olxssa/perfusion_automation/FreeCAD_Files/syringe_pumps/688085-open-source-syringe-pumps-e49d6351-b8a2-4a63-a908-39e2536a6fdb.pdf

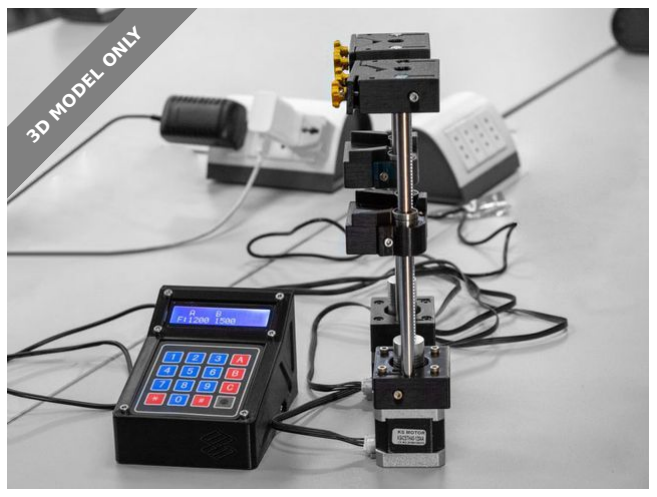
[picture p13: figure]
3D MODEL ONLY

## Summary

3D printable syringe pumps for laboratory or hobby use, including microfluidics, mass-spectrometry, and microscopy.

Learning (https://printables.com/model?categoryId=90) > Chemistry & Biology (https://printables.com/model?categoryId=92)

Tags: | motor | stepper | electronics | pump | microfluidics
opensource | syringe | m3 | openhardware | droplet
heatinsert | librehub

The open-source syringe pump is a standard research instrument for use in microfluidics and several other laboratory workflows. There are numerous designs available in the realm of open-source syringe pumps. We have combined some the best features available based on a preexisting versatile design.

To build these pumps you can check our free documentation. (https://librehub.github.io/syringe-pumps-and-controller/testpage1.html) To make modifications see our online CAD model. (https://cad.onshape.com/documents/20c077b452e92115525d4fed/w/71118f46b0924c1bb22b1150/e/4bcaa57486327617beecf77e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)

Our strobe-enhanced microscopy stage (https://www.printables.com/model/647564-strobe-enhanced-microscopy-stage) works great with these syringe pumps, to complete an open-source workstation for imaging fast processes, particularly developed for microfluidic droplet generation.

LIBRE hub (https://printables.com/@WenzelLab)

## Open-Source Syringe Pumps

VIEW IN BROWSER (https://printables.com/model/688085-open-source-syringe-pumps)

updated 9. 5. 2024 | published 9. 5. 2024

Open-Source
Syringe
Pump

## Model files

This is a re-design and modification of the "Open-Source Syringe
Pump" (https://link.springer.com/article/10.1134/S1061934820030156) (documentation) (https://www.mass-spec.ru/projects/diy/syringe_pump/eng/) developed by Andrey Samokhin, made by Matías Hurtado Labarca (https://librehub.github.io/people/matias_hurtado/index.html) and Tobias Wenzel (https://twitter.com/MakerTobey) as part of the LIBRE hub (https://librehub.github.io/) project.

## This remix is based on

Open-Source Syringe Pump (https://www.mass-spec.ru/projects/diy/syringe_pump/eng/)

- Simulation
- Optional Holding System for retraction assembled-syringe-pump.stl

small-syringe-holder.stl

add-on-end-stop-limit.stl

add-on-thread-holder.stl

large-syringe-holder.stl

add-ons-to-operate-pumps-in-retraction-mode.stl

## License

This work is licensed under a
Creative Commons (4.0 International License)

Attribution (http://creativecommons.org/licenses/by/4.0/)

✖ | Sharing without ATTRIBUTION
✔ | Remix Culture allowed
✔ | Commercial Use
✔ | Free Cultural Works
✔ | Meets Open Definition

base-syringe-holder.stl

knob.stl

base-carriage.stl

base-stepper-motor-plate.stl
