olxssa/perfusion_automation/FPC/from_memetis/image 2.png

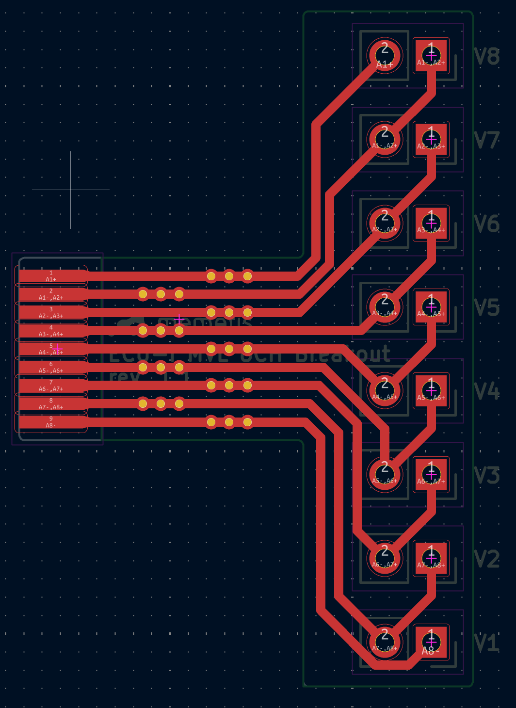
FPC/from_memetis/image 2.png
