olxssa/perfusion_automation/FPC/from_memetis/image.png

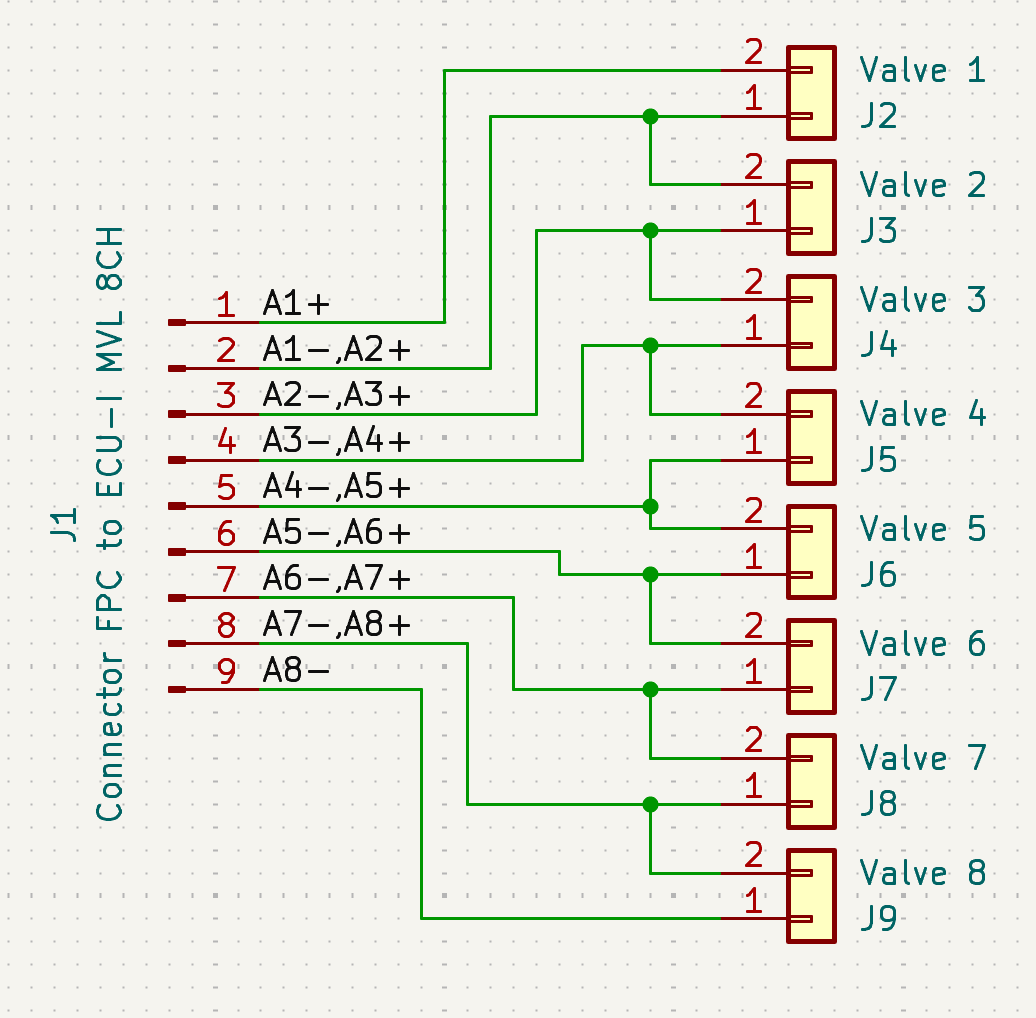
FPC/from_memetis/image.png
