olxssa/perfusion_automation/images/electrical_circuit.jpg

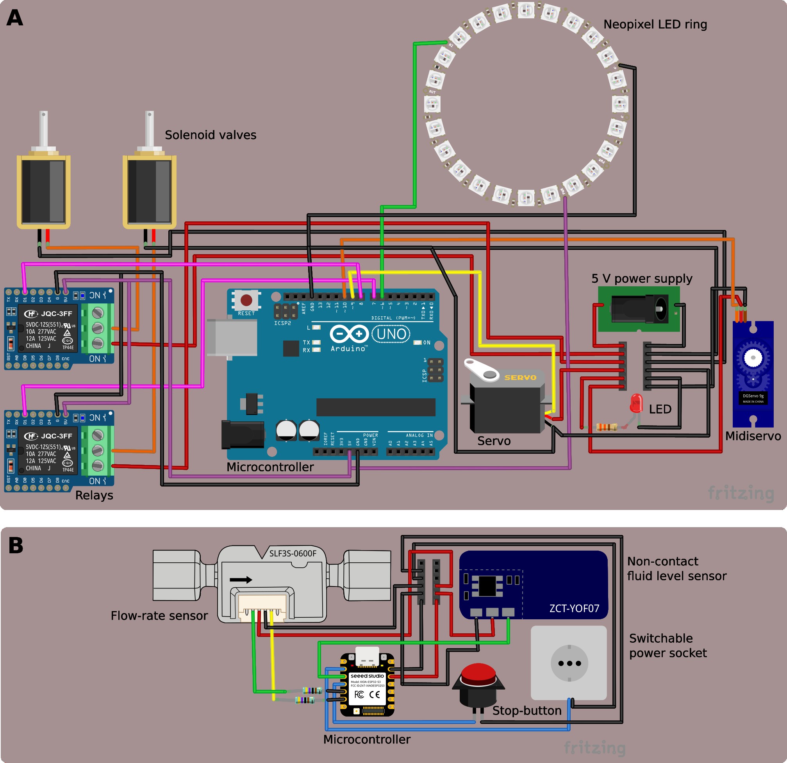
images/electrical_circuit.jpg
