olxssa/perfusion_automation/images/electrical_circuit.png

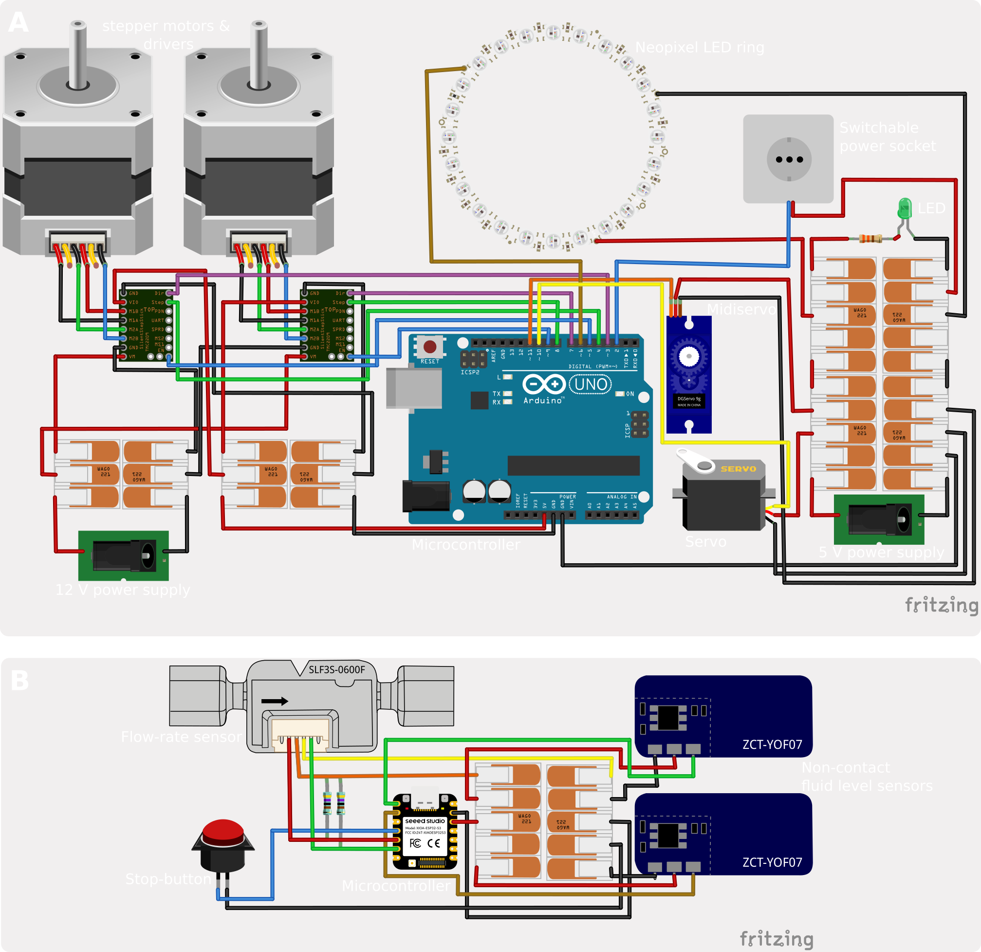
images/electrical_circuit.png
