olxssa/perfusion_automation/images/fluidic_circuit.jpg

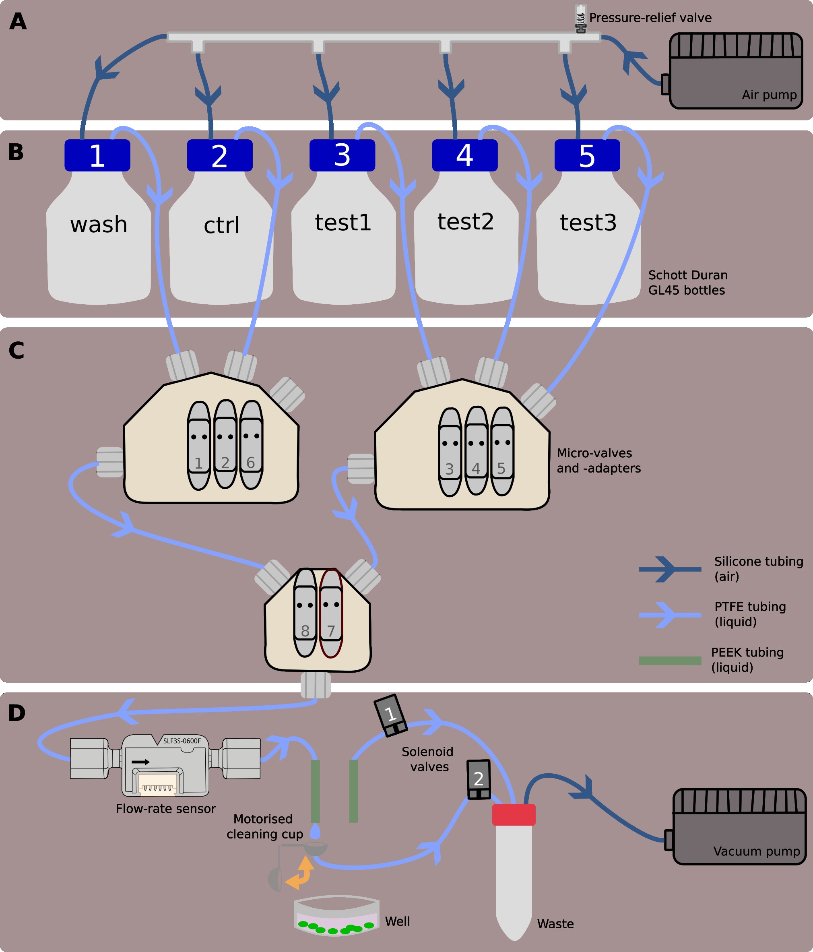
images/fluidic_circuit.jpg
