olxssa/perfusion_automation/images/fluidic_circuit.png

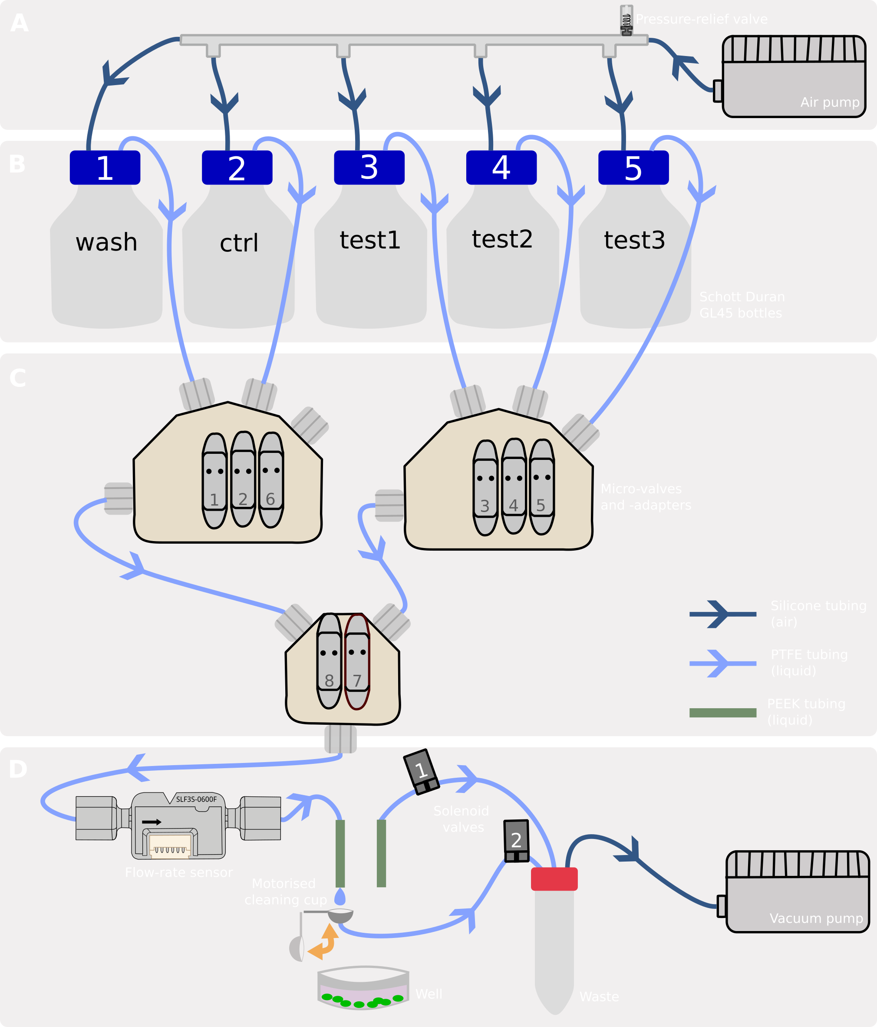
images/fluidic_circuit.png
