olxssa/perfusion_automation/images/gui.png

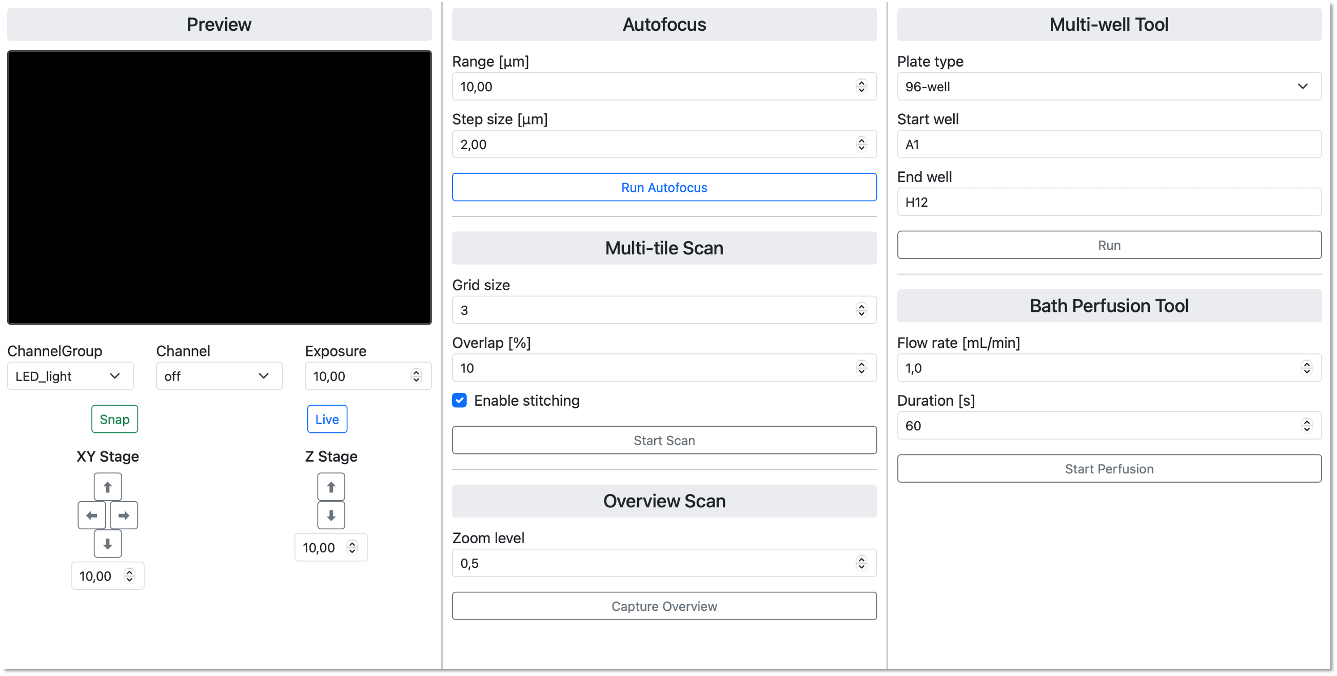
images/gui.png
