olxssa/perfusion_automation/images/gui_v2.png

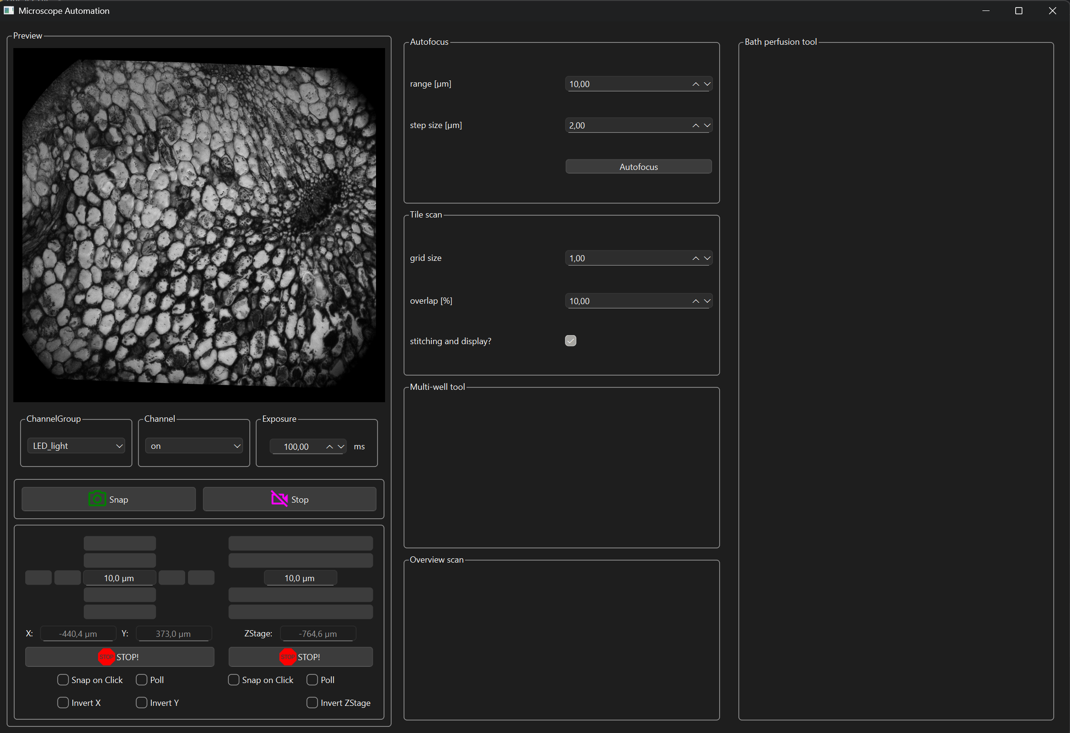
images/gui_v2.png
