olxssa/perfusion_automation/images/img.png

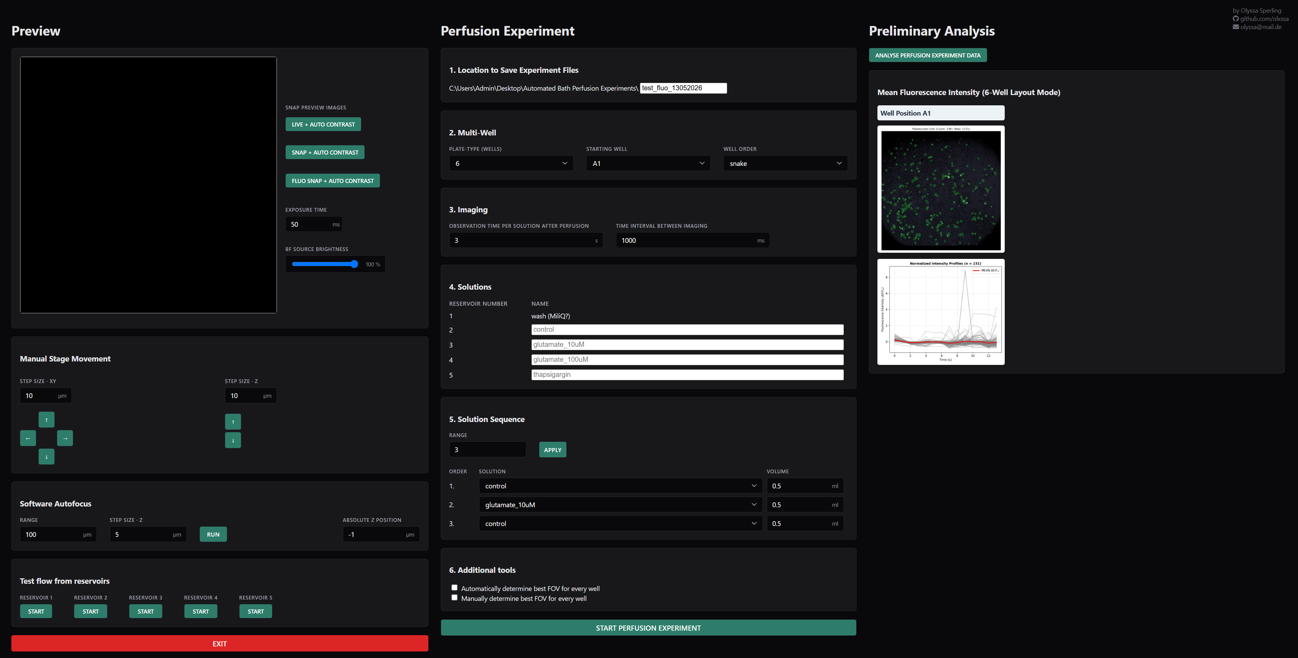
images/img.png
