olxssa/perfusion_automation/images/img_design.png

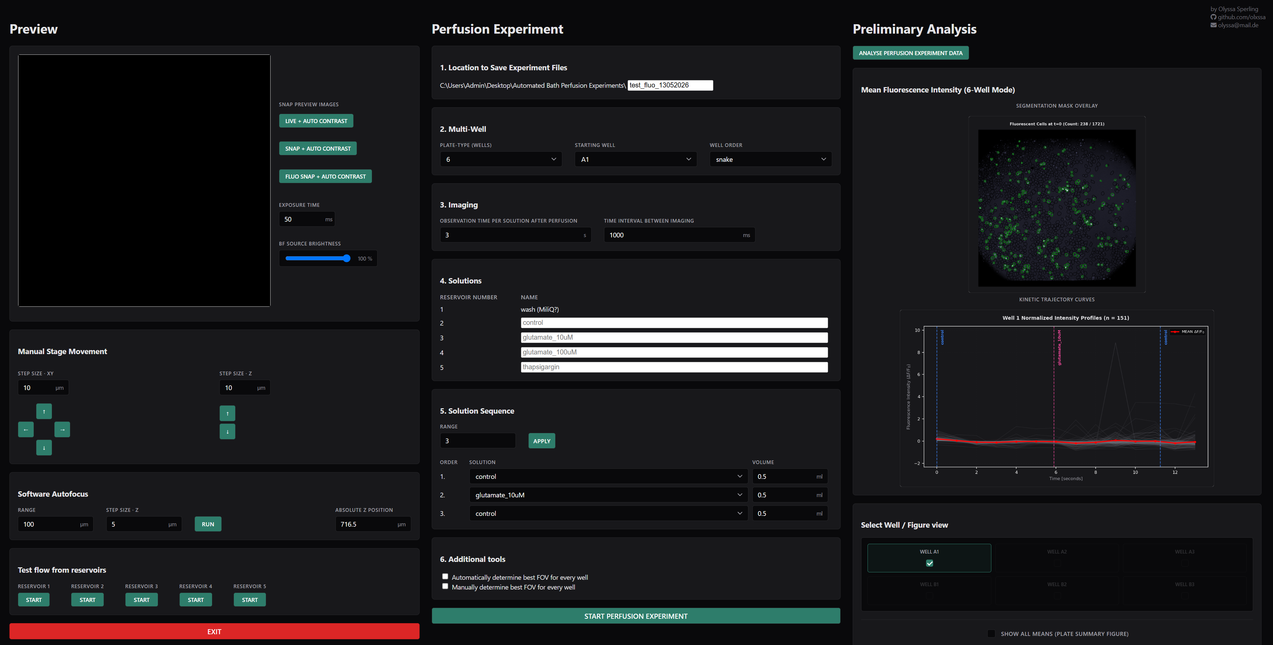
images/img_design.png
