olxssa/perfusion_automation/images/solenoid_Steckplatine_sensor.png

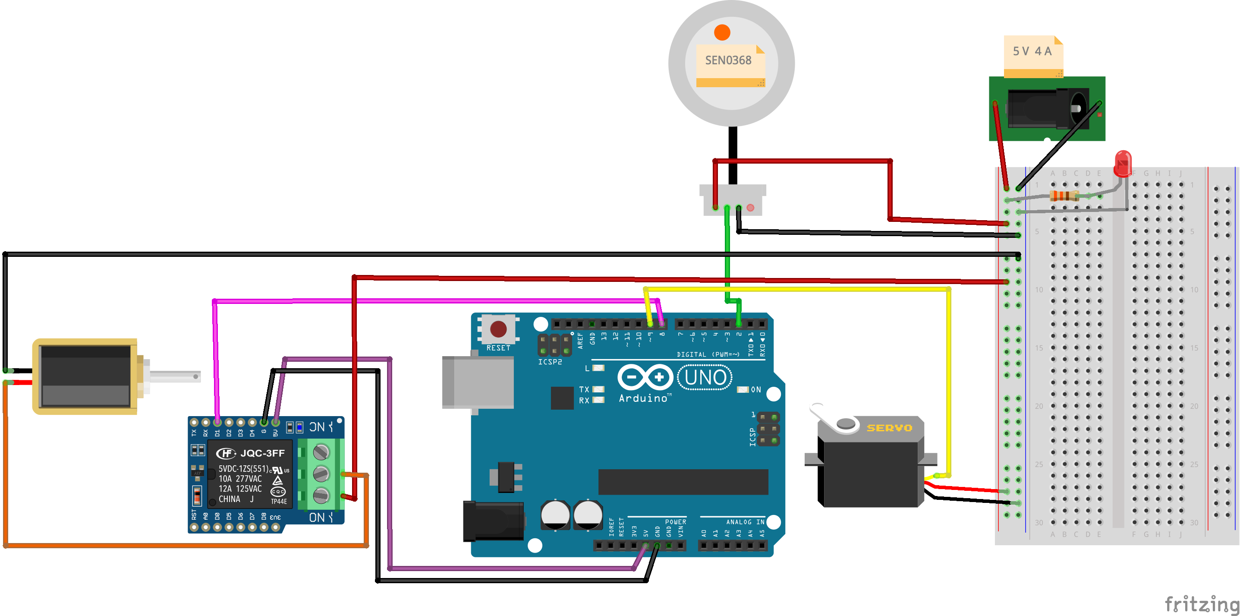
images/solenoid_Steckplatine_sensor.png
