olxssa/perfusion_automation/images/stop_button.png

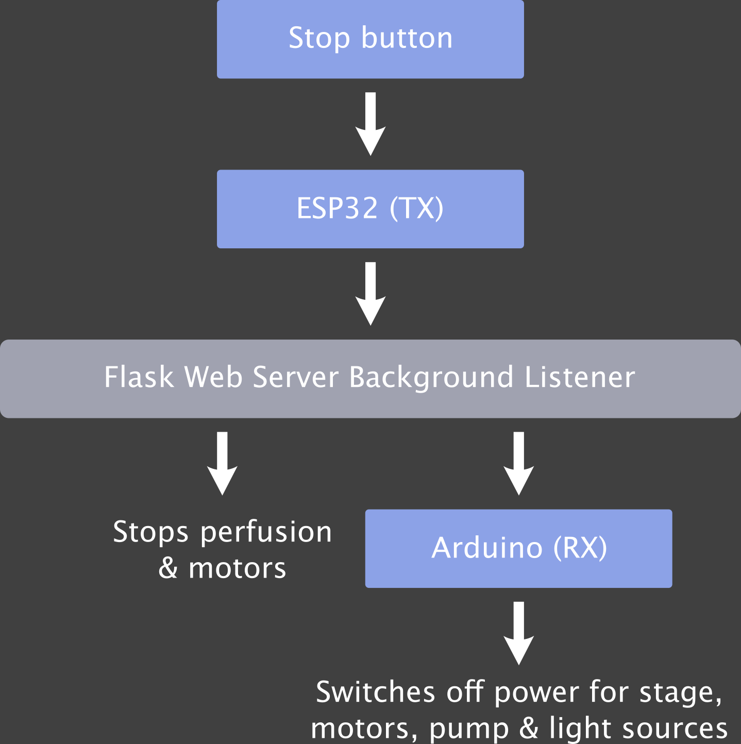
images/stop_button.png
