olxssa/perfusion_automation/images/web_app.jpg

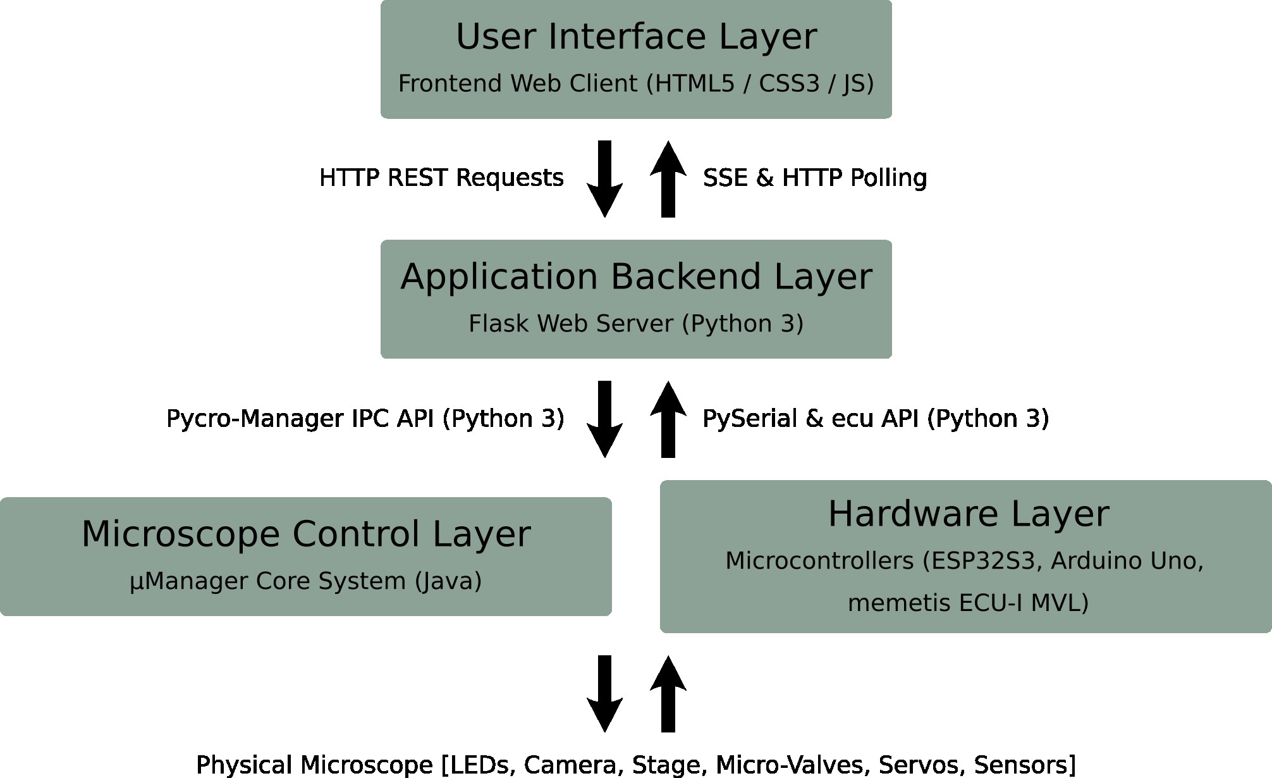
images/web_app.jpg
