olxssa/perfusion_automation/images/web_app.png

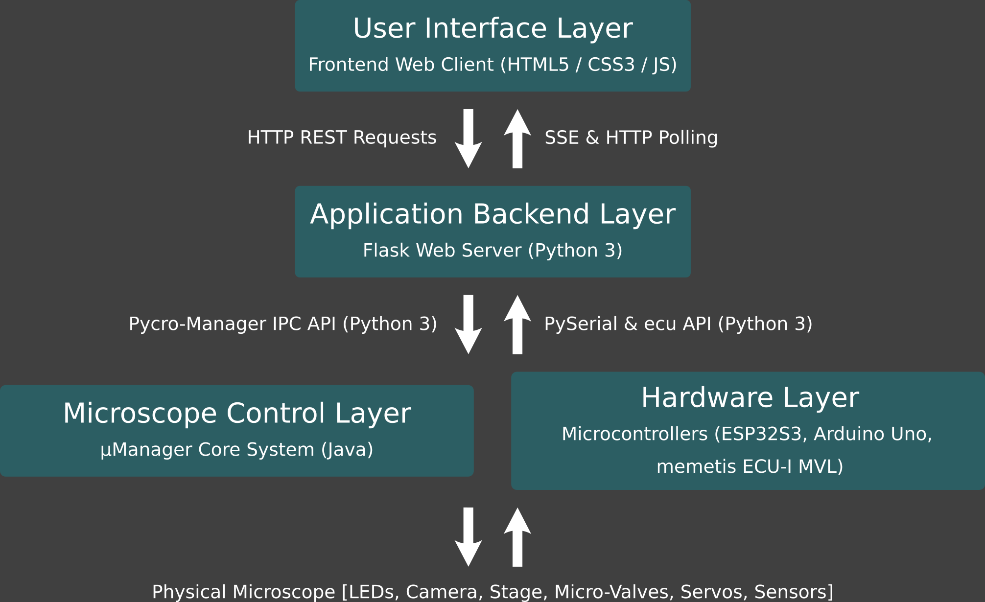
images/web_app.png
