olxssa/perfusion_automation/images/webapp_current_state.png

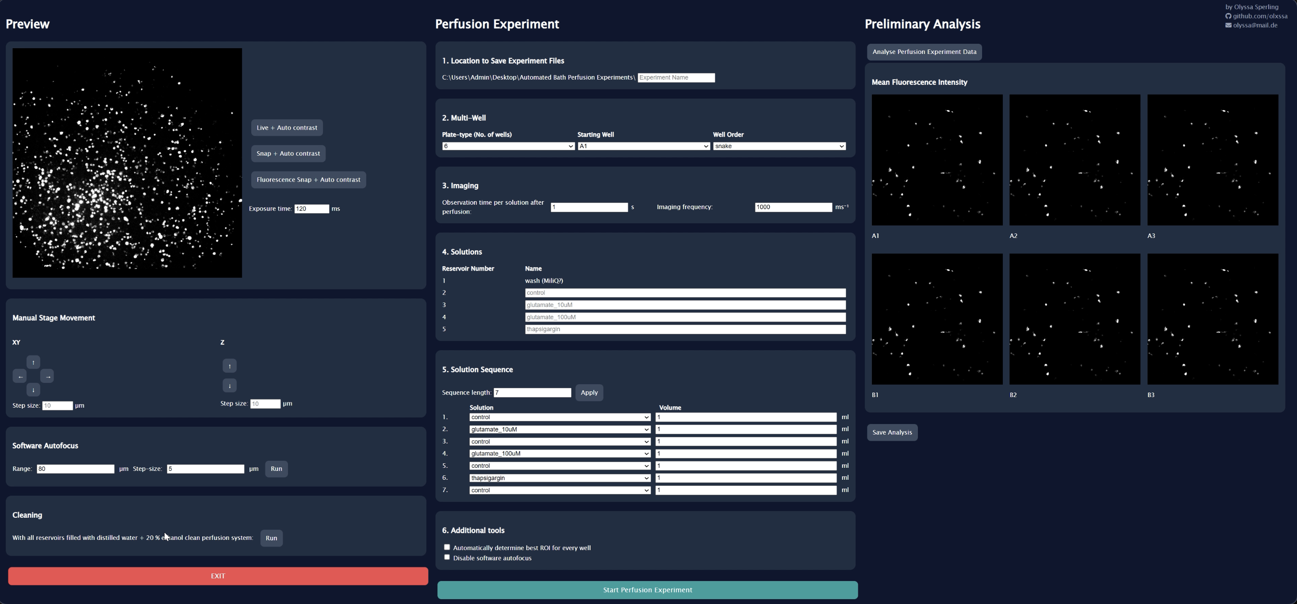
images/webapp_current_state.png
