olxssa/perfusion_automation/FreeCAD_Files/syringe_pumps/complete_syringepump_adapted.3mf

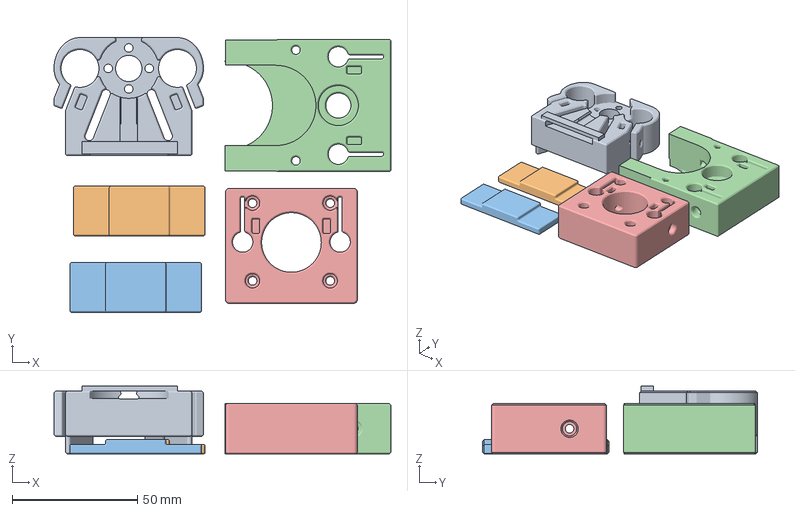
[picture p29: CAD file, 2026-10-26]
FreeCAD_Files/syringe_pumps/complete_syringepump_adapted.3mf
134.5 x 109.7 x 27.0 mm
carriage_OLYSSA.stl
syringe-holder_OLYSSA.stl x 2
Merged
Base - Stepper motor plate.stl
