olxssa/perfusion_automation/FreeCAD_Files/ECU-I Case/ECU_I_case_bottom_alternative.FCStd

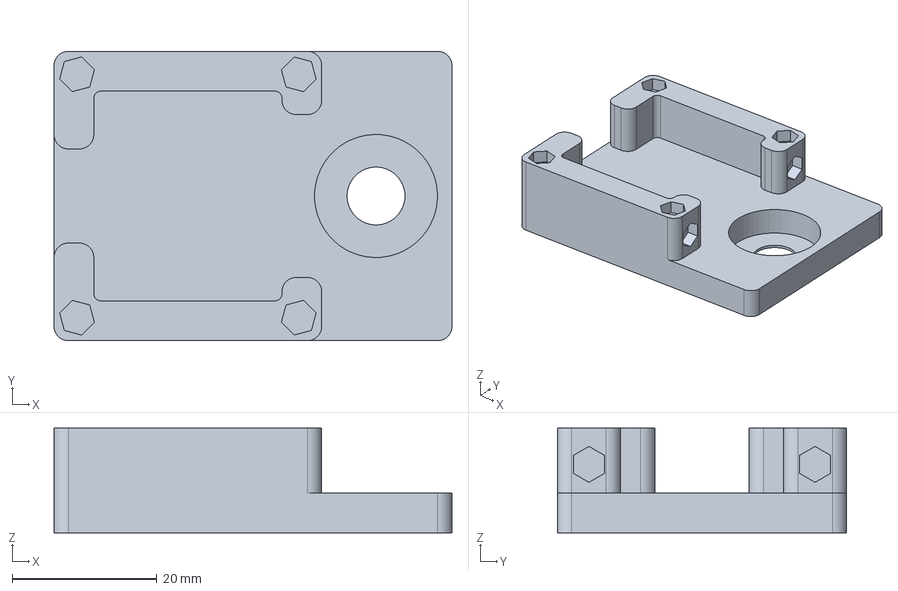
[picture p30: CAD file, 2026-10-18]
FreeCAD_Files/ECU-I Case/ECU_I_case_bottom_alternative.FCStd
55.0 x 40.0 x 14.5 mm
