olxssa/perfusion_automation/FreeCAD_Files/ecui_case/ecui_case_base.FCStd

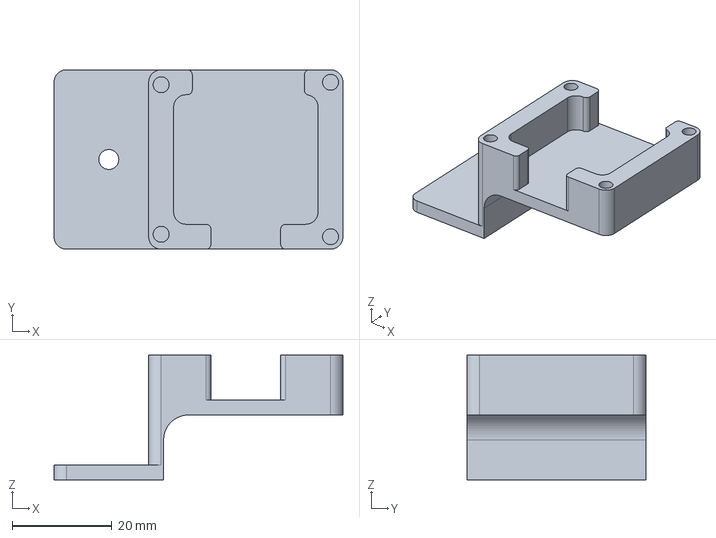
[picture p31: CAD file, 2026-10-26]
FreeCAD_Files/ecui_case/ecui_case_base.FCStd
58.0 x 36.0 x 25.0 mm
