olxssa/perfusion_automation/FreeCAD_Files/Electronics casing/eletronics_casing_bottom.FCStd

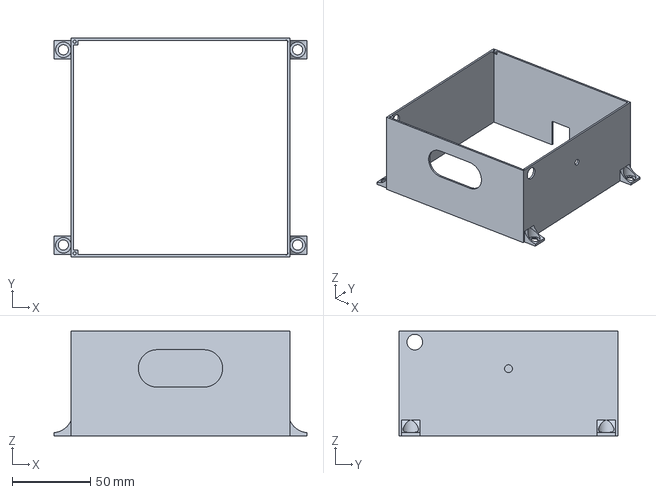
[picture p32: CAD file, 2026-10-18]
FreeCAD_Files/Electronics casing/eletronics_casing_bottom.FCStd
162.0 x 140.0 x 67.0 mm
