olxssa/perfusion_automation/FreeCAD_Files/electronics_case/electronics_case_top.FCStd

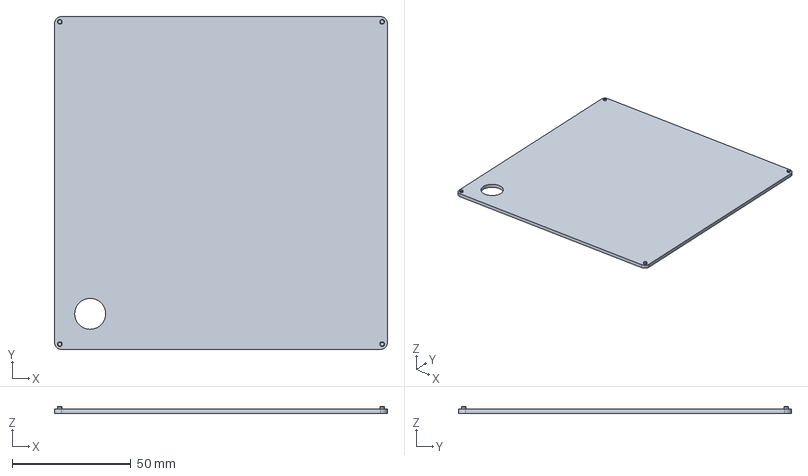
[picture p33: CAD file, 2026-10-26]
FreeCAD_Files/electronics_case/electronics_case_top.FCStd
140.0 x 140.0 x 3.00 mm
