olxssa/perfusion_automation/FreeCAD_Files/Miscellaneous/cap_olimex_socket.FCStd

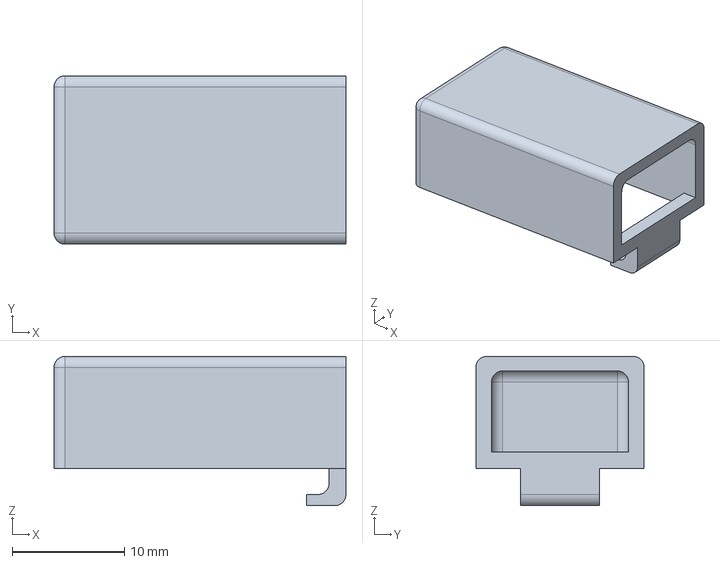
[picture p34: CAD file, 2026-10-26]
FreeCAD_Files/Miscellaneous/cap_olimex_socket.FCStd
26.0 x 15.0 x 13.3 mm
