olxssa/perfusion_automation/FreeCAD_Files/Mount for Servos and Gear Wheel/waste_cup.FCStd

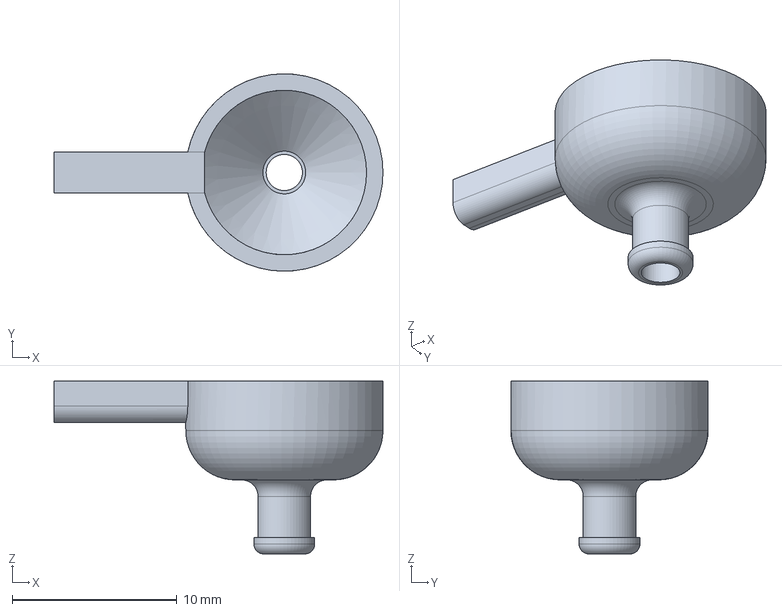
[picture p35: CAD file, 2026-10-18]
FreeCAD_Files/Mount for Servos and Gear Wheel/waste_cup.FCStd
20.0 x 12.0 x 10.5 mm
