olxssa/perfusion_automation/FreeCAD_Files/mount_servos_and_gear_wheel/aluprofile_mount.FCStd

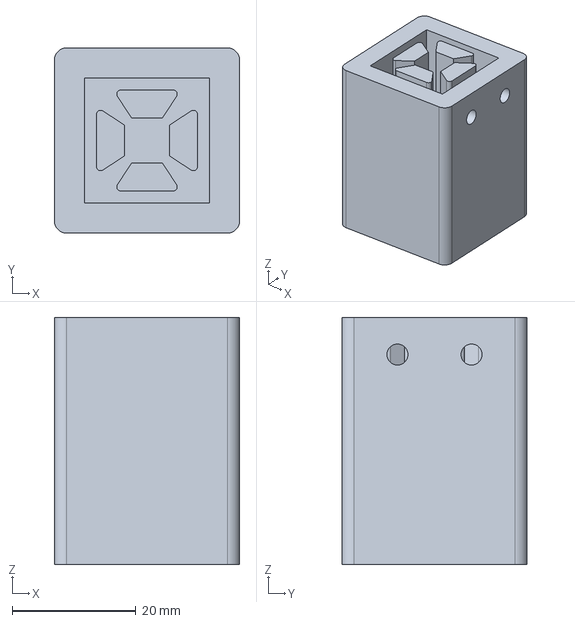
[picture p36: CAD file, 2026-10-26]
FreeCAD_Files/mount_servos_and_gear_wheel/aluprofile_mount.FCStd
30.0 x 30.0 x 40.0 mm
