olxssa/perfusion_automation/FreeCAD_Files/Reservoir Mount and GL45 inserts/pressure_rack_mount_v2.FCStd

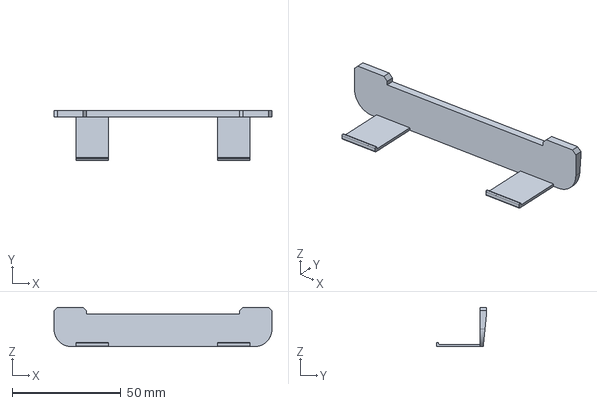
[picture p37: CAD file, 2026-10-18]
FreeCAD_Files/Reservoir Mount and GL45 inserts/pressure_rack_mount_v2.FCStd
100.0 x 23.0 x 18.0 mm
