olxssa/perfusion_automation/FreeCAD_Files/reservoir_mount_and_GL45_inserts/sealing_ring.FCStd

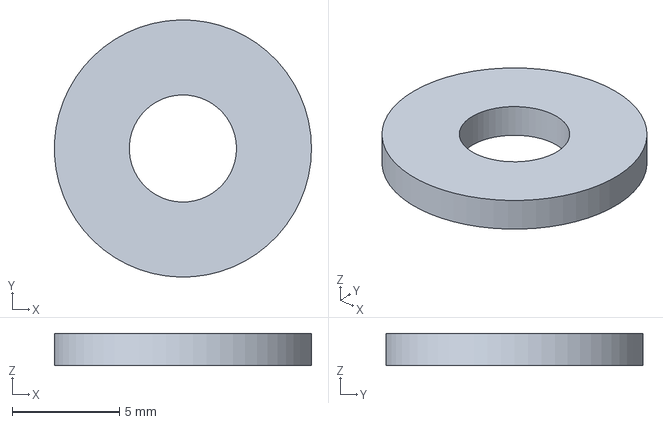
[picture p38: CAD file, 2026-10-26]
FreeCAD_Files/reservoir_mount_and_GL45_inserts/sealing_ring.FCStd
12.0 x 12.0 x 1.50 mm
