olxssa/perfusion_automation/FreeCAD_Files/syringe_pumps/stepper_mount.FCStd

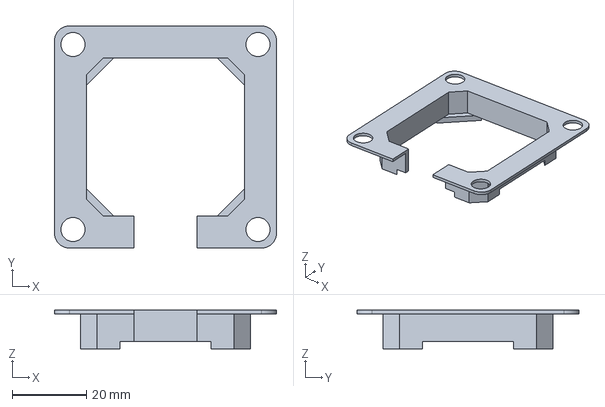
[picture p39: CAD file, 2026-10-26]
FreeCAD_Files/syringe_pumps/stepper_mount.FCStd
60.0 x 60.0 x 10.5 mm
