olxssa/perfusion_automation/FreeCAD_Files/Valve Adapter Rack and LED Ring/LED_ring_mount.FCStd

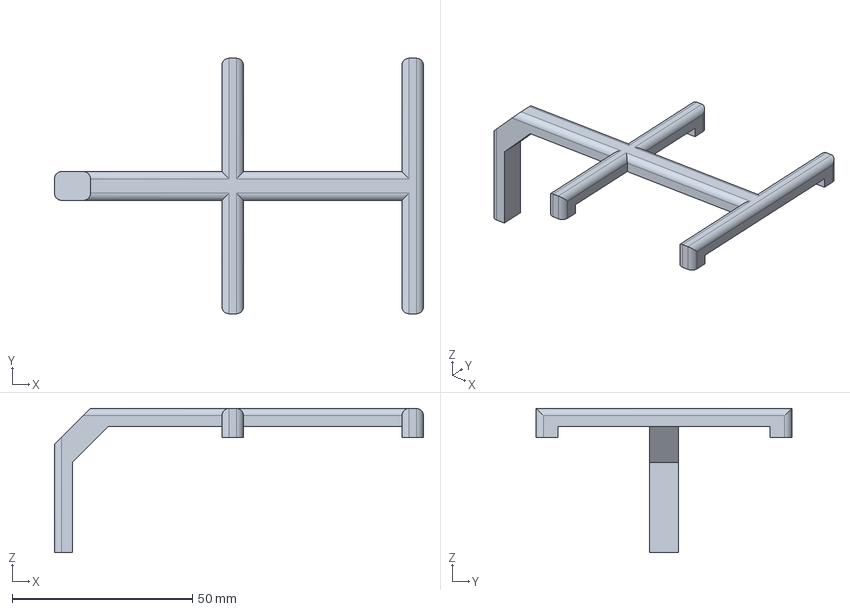
[picture p40: CAD file, 2026-10-18]
FreeCAD_Files/Valve Adapter Rack and LED Ring/LED_ring_mount.FCStd
102.5 x 71.0 x 40.0 mm
