olxssa/perfusion_automation/FreeCAD_Files/valve_adapter_rack_and_LED_ring/diffuser.FCStd

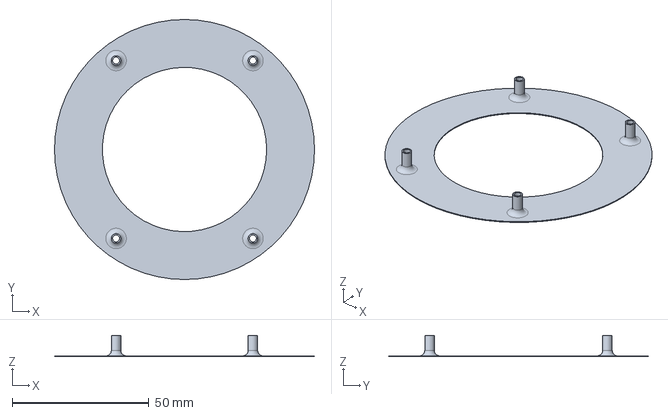
[picture p41: CAD file, 2026-10-26]
FreeCAD_Files/valve_adapter_rack_and_LED_ring/diffuser.FCStd
95.0 x 95.0 x 7.80 mm
