olxssa/perfusion_automation/FreeCAD_Files/ECU-I Case/ECU_I_case_top_alternative.FCStd

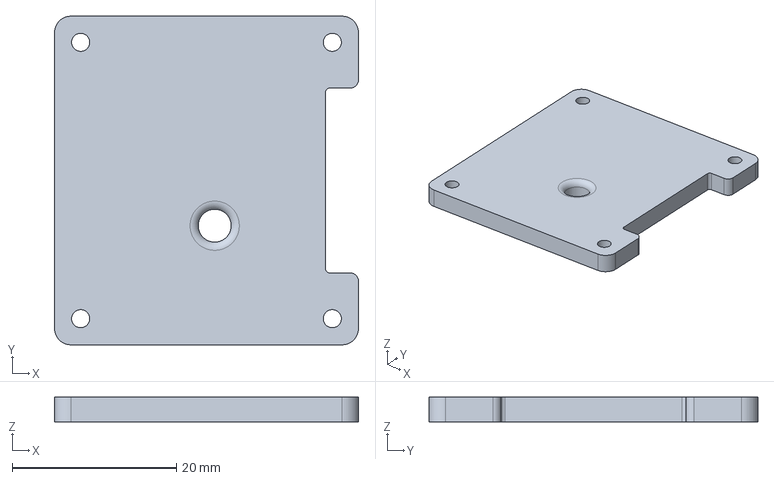
[picture p42: CAD file, 2026-10-18]
FreeCAD_Files/ECU-I Case/ECU_I_case_top_alternative.FCStd
37.0 x 40.0 x 3.00 mm
