olxssa/perfusion_automation/FreeCAD_Files/ecui_case/ecui_case_top.FCStd

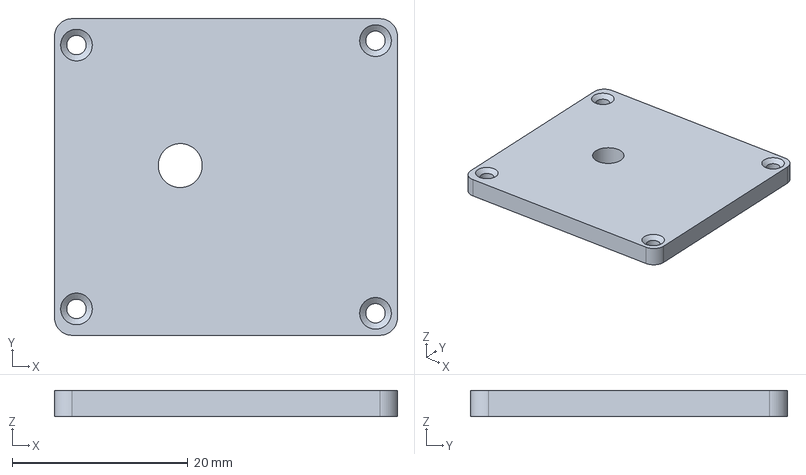
[picture p43: CAD file, 2026-10-26]
FreeCAD_Files/ecui_case/ecui_case_top.FCStd
39.0 x 36.0 x 3.00 mm
