olxssa/perfusion_automation/FreeCAD_Files/electronics_case/electronics_case_base.FCStd

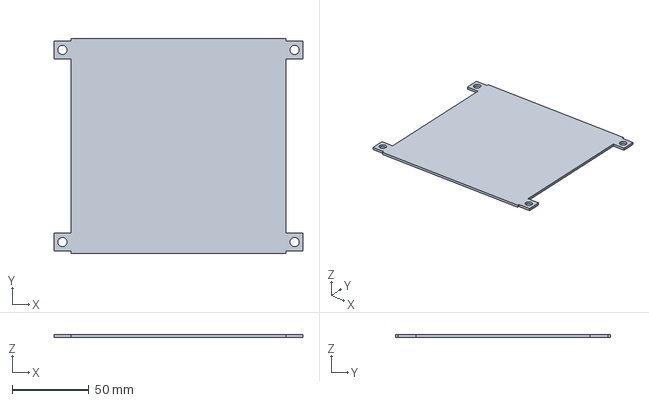
[picture p44: CAD file, 2026-10-26]
FreeCAD_Files/electronics_case/electronics_case_base.FCStd
162.0 x 140.0 x 2.00 mm
