olxssa/perfusion_automation/FreeCAD_Files/Miscellaneous/case_esp32.FCStd

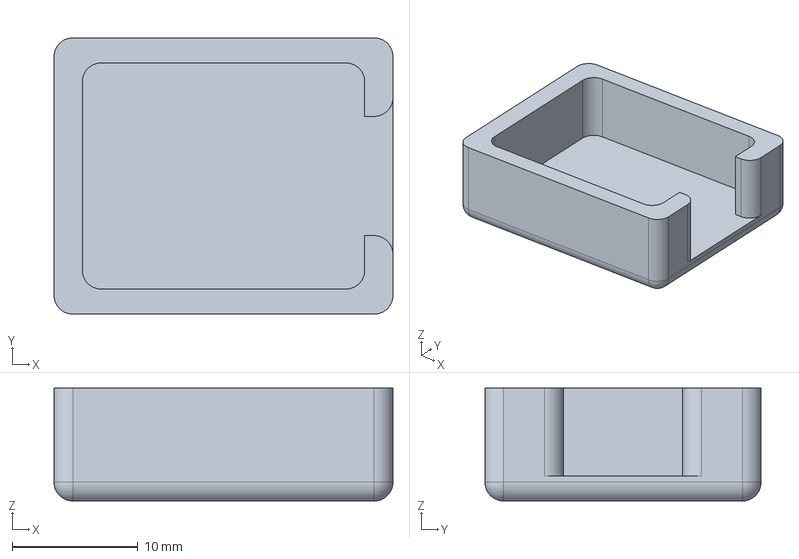
[picture p45: CAD file, 2026-10-18]
FreeCAD_Files/Miscellaneous/case_esp32.FCStd
27.0 x 22.0 x 9.00 mm
