olxssa/perfusion_automation/FreeCAD_Files/Mount for Servos and Gear Wheel/zgear_servo.FCStd

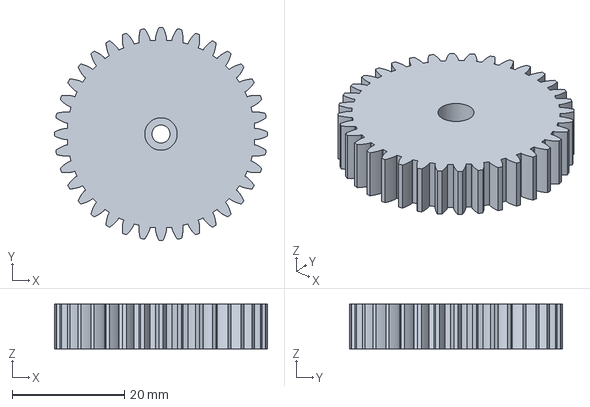
[picture p46: CAD file, 2026-10-18]
FreeCAD_Files/Mount for Servos and Gear Wheel/zgear_servo.FCStd
38.0 x 38.0 x 8.00 mm
