olxssa/perfusion_automation/FreeCAD_Files/mount_servos_and_gear_wheel/gear_rail_microservo_mount.FCStd

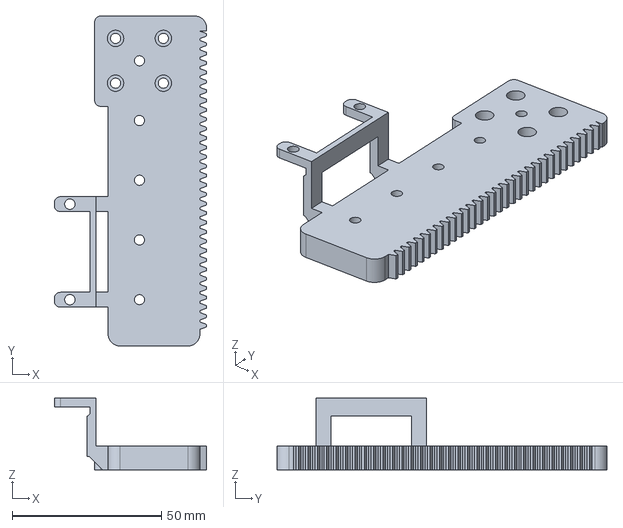
[picture p47: CAD file, 2026-10-26]
FreeCAD_Files/mount_servos_and_gear_wheel/gear_rail_microservo_mount.FCStd
51.0 x 110.5 x 24.0 mm
