olxssa/perfusion_automation/FreeCAD_Files/Reservoir Mount and GL45 inserts/GL45_insert_3_9.FCStd

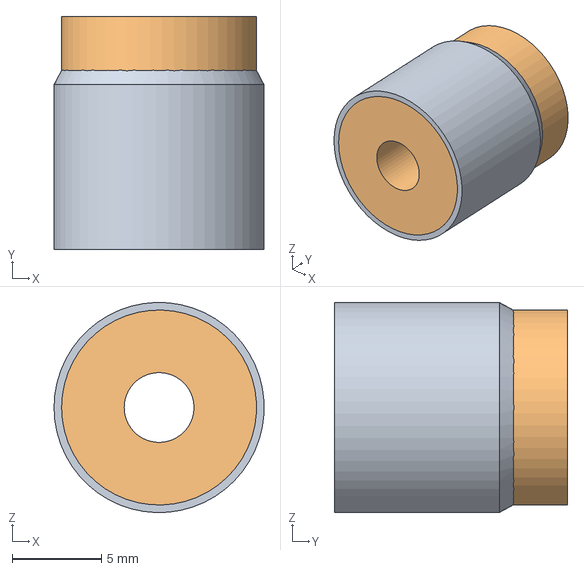
[picture p48: CAD file, 2026-10-18]
FreeCAD_Files/Reservoir Mount and GL45 inserts/GL45_insert_3_9.FCStd
11.7 x 13.0 x 11.7 mm
(Unsaved)
