olxssa/perfusion_automation/FreeCAD_Files/reservoir_mount_and_GL45_inserts/reservoir_mount.FCStd

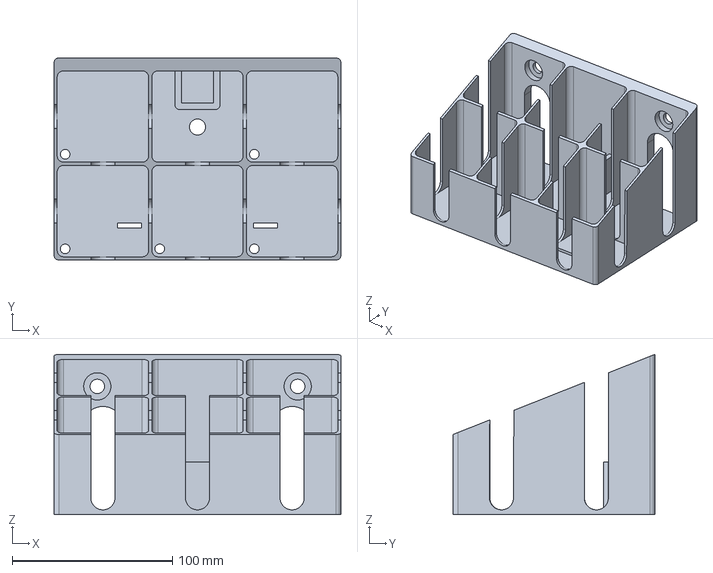
[picture p49: CAD file, 2026-10-26]
FreeCAD_Files/reservoir_mount_and_GL45_inserts/reservoir_mount.FCStd
179.0 x 126.0 x 100.0 mm
