olxssa/perfusion_automation/FreeCAD_Files/Valve Adapter Rack and LED Ring/Flow_rate_sensor_Mount.FCStd

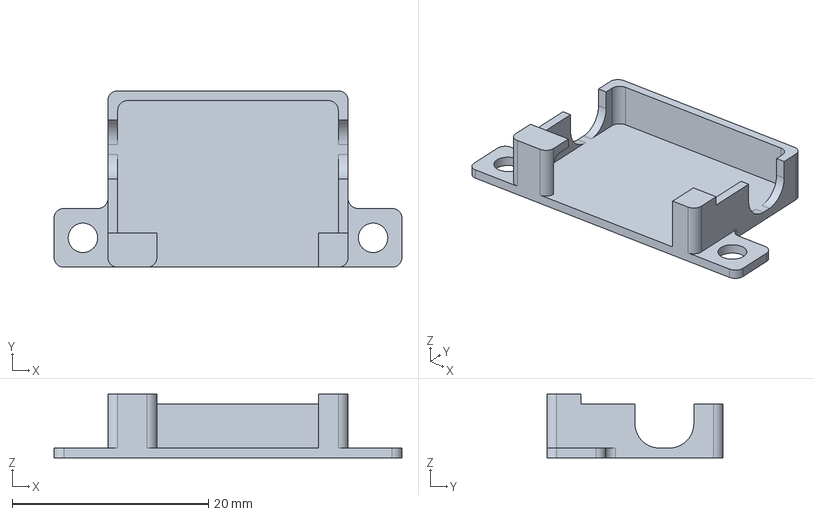
[picture p50: CAD file, 2026-10-18]
FreeCAD_Files/Valve Adapter Rack and LED Ring/Flow_rate_sensor_Mount.FCStd
35.5 x 18.0 x 6.50 mm
