olxssa/perfusion_automation/FreeCAD_Files/valve_adapter_rack_and_LED_ring/adapter_rack.FCStd

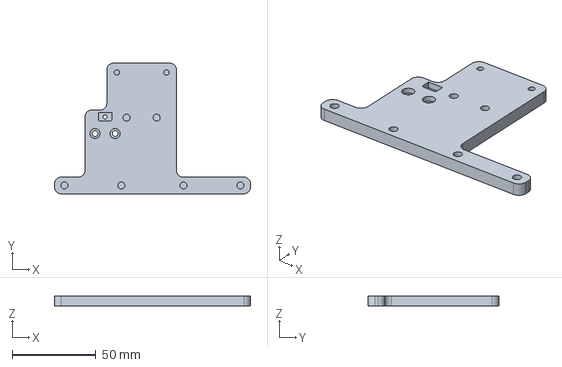
[picture p51: CAD file, 2026-10-26]
FreeCAD_Files/valve_adapter_rack_and_LED_ring/adapter_rack.FCStd
117.0 x 78.0 x 6.00 mm
