olxssa/perfusion_automation/FreeCAD_Files/ECU-I Case/ECU_I_case_FCC_cable_mount.FCStd

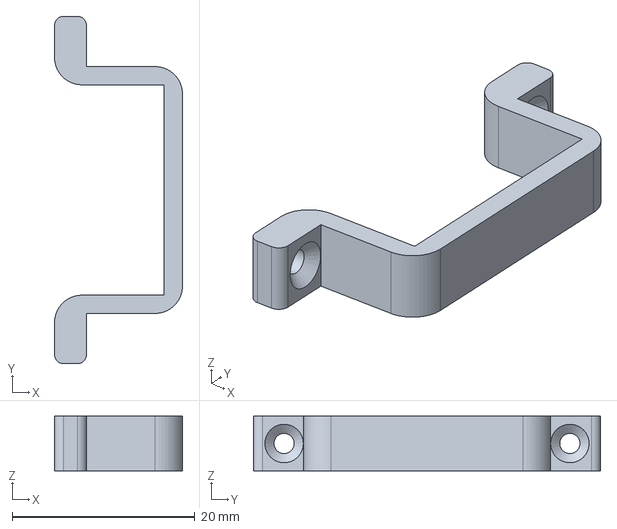
[picture p52: CAD file, 2026-10-18]
FreeCAD_Files/ECU-I Case/ECU_I_case_FCC_cable_mount.FCStd
14.0 x 38.0 x 6.00 mm
