olxssa/perfusion_automation/FreeCAD_Files/Mount for Servos and Gear Wheel/gegenst.FCStd

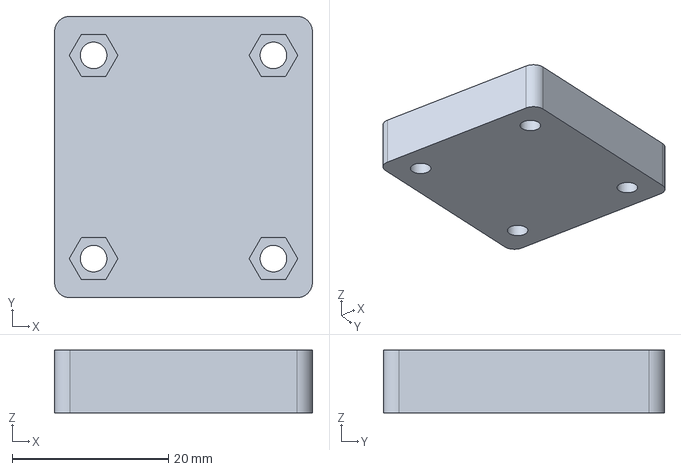
[picture p53: CAD file, 2026-10-18]
FreeCAD_Files/Mount for Servos and Gear Wheel/gegenst.FCStd
33.0 x 36.0 x 8.00 mm
