olxssa/perfusion_automation/FreeCAD_Files/mount_servos_and_gear_wheel/plate.FCStd

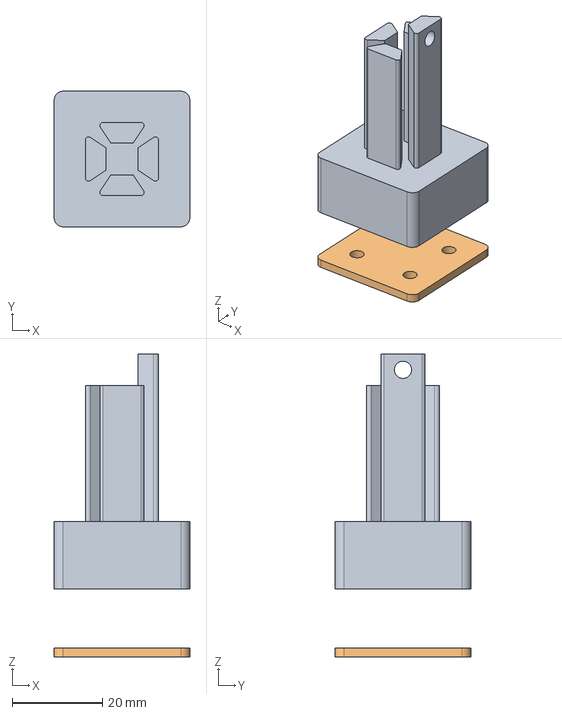
[picture p54: CAD file, 2026-10-26]
FreeCAD_Files/mount_servos_and_gear_wheel/plate.FCStd
30.0 x 30.0 x 67.0 mm
Körper
Körper001
