olxssa/perfusion_automation/FreeCAD_Files/Valve Adapter Rack and LED Ring/memetis_valve_bottom.FCStd

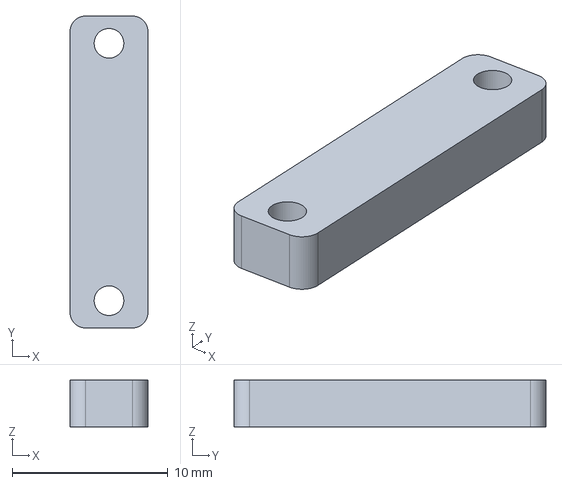
[picture p55: CAD file, 2026-10-18]
FreeCAD_Files/Valve Adapter Rack and LED Ring/memetis_valve_bottom.FCStd
5.00 x 20.0 x 3.00 mm
