olxssa/perfusion_automation/FreeCAD_Files/Mount for Servos and Gear Wheel/zachse_servo_base.FCStd

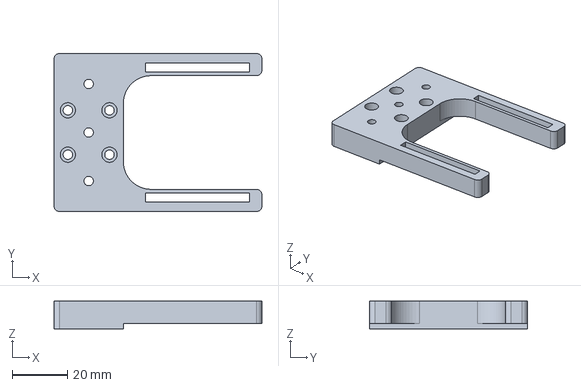
[picture p56: CAD file, 2026-10-18]
FreeCAD_Files/Mount for Servos and Gear Wheel/zachse_servo_base.FCStd
75.0 x 57.0 x 10.0 mm
