olxssa/perfusion_automation/FreeCAD_Files/Mount for Servos and Gear Wheel/micro_servo_mount_v2.FCStd

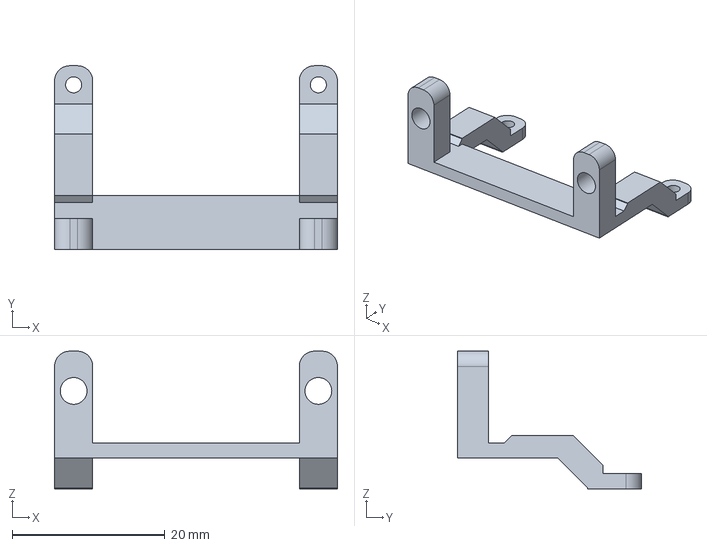
[picture p57: CAD file, 2026-10-18]
FreeCAD_Files/Mount for Servos and Gear Wheel/micro_servo_mount_v2.FCStd
37.0 x 24.0 x 18.0 mm
