olxssa/perfusion_automation/images/fluid_wiring.png

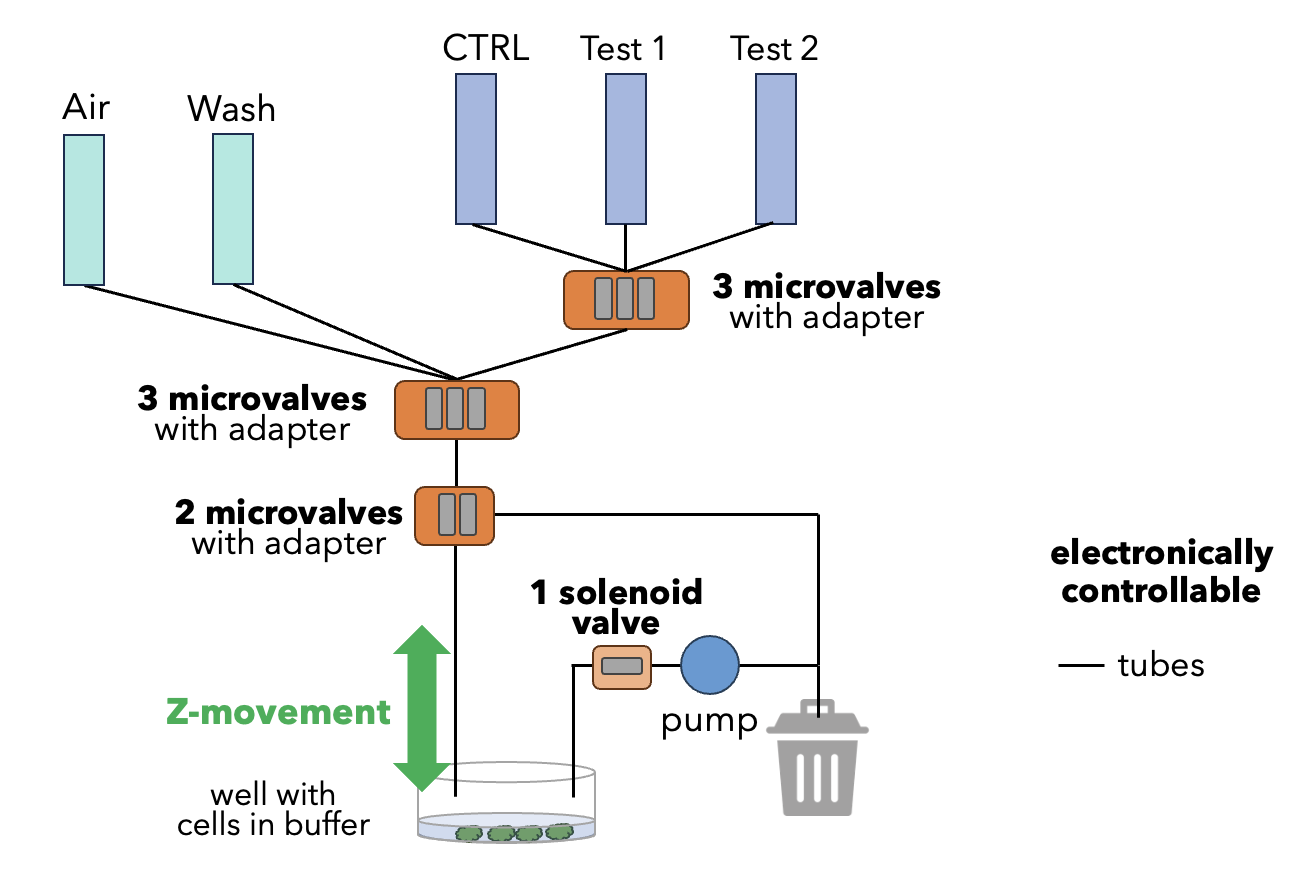
images/fluid_wiring.png
