olxssa/perfusion_automation/images/microscope_setup.png

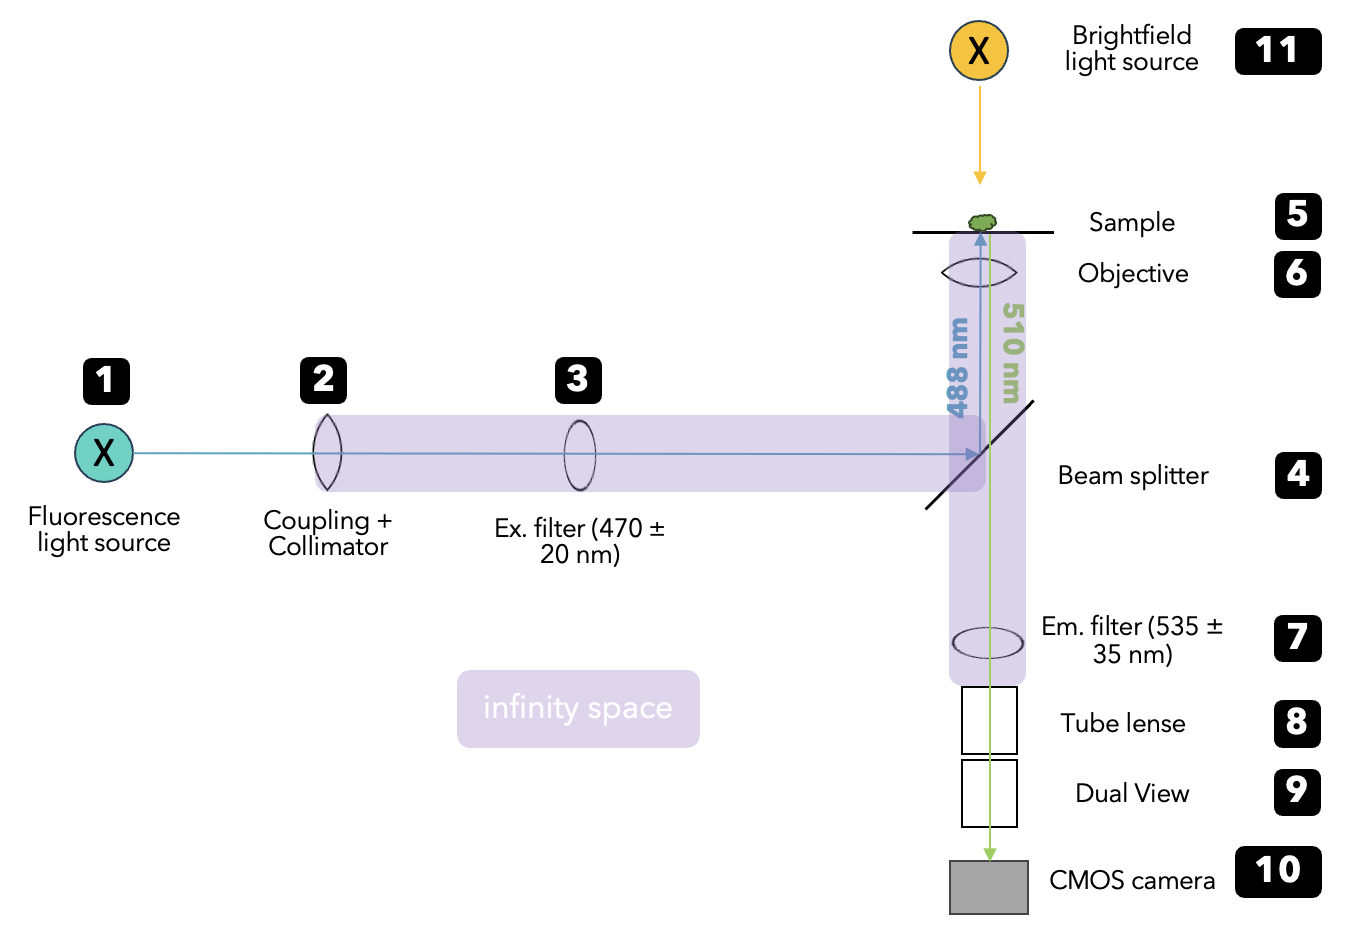
images/microscope_setup.png
