olxssa/perfusion_automation/Data_for_Repository/Calibration_Benchmarking/Correct_Volume_Exchange/fluorescence_time_series.csv

Time_Frame | Total_Intensity
0 | 16783118
1 | 16883562
2 | 16758857
3 | 16855324
4 | 16690930
5 | 16653681
6 | 16490551
7 | 16252764
8 | 16035202
9 | 16009525
10 | 16219264
11 | 15943752
12 | 15852220
13 | 15837128
14 | 15990464
15 | 15564927
16 | 15494287
17 | 15847222
18 | 16367543
19 | 16378113
20 | 15932934
21 | 16259809
22 | 16724164
23 | 16331968
24 | 16039395
25 | 16195775
26 | 16459152
27 | 16589281
28 | 16398325
29 | 16101258
30 | 15821526
31 | 16158604
32 | 16111208
33 | 16039931
34 | 16529395
35 | 16840855
36 | 16137641
37 | 15395803
38 | 16012072
39 | 16746484
40 | 16789064
41 | 16628541
42 | 16863576
43 | 19413630
44 | 21339830
45 | 21157879
46 | 19626810
47 | 19869912
48 | 20087492
49 | 20575550
50 | 21072932
51 | 21856007
52 | 22775607
53 | 23936500
54 | 24752284
55 | 26759162
56 | 28585871
57 | 30161303
58 | 29300848
59 | 30847408
60 | 27504533
61 | 30730114
62 | 34263905
63 | 38180736
64 | 36609252
65 | 45148959
66 | 41289145
67 | 38611696
68 | 41067659
69 | 38752273
70 | 38708493
71 | 33502421
72 | 33878361
73 | 34869961
74 | 36874935
75 | 38402960
76 | 39880348
77 | 37234259
78 | 36073342
79 | 34476237
80 | 31208665
81 | 26916261
82 | 21670505
83 | 20127673
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
