olxssa/perfusion_automation/Data_for_Repository/Calibration_Benchmarking/Flow_Rate_Optimization/flow_rate_nrreservoirs_5_30s.csv

Time | Flow-rate [ul/min]
2026-10-12 16:01:27 | -0.600
2026-10-12 16:01:27 | -0.500
2026-10-12 16:01:27 | 0.100
2026-10-12 16:01:27 | -0.300
2026-10-12 16:01:27 | 0.100
2026-10-12 16:01:27 | -0.200
2026-10-12 16:01:27 | -0.100
2026-10-12 16:01:27 | -0.100
2026-10-12 16:01:27 | -0.100
2026-10-12 16:01:27 | 0.000
2026-10-12 16:01:27 | -0.200
2026-10-12 16:01:28 | 0.000
2026-10-12 16:01:28 | -0.100
2026-10-12 16:01:28 | 0.100
2026-10-12 16:01:28 | -0.200
2026-10-12 16:01:28 | 0.000
2026-10-12 16:01:28 | -0.100
2026-10-12 16:01:28 | 0.100
2026-10-12 16:01:28 | -0.200
2026-10-12 16:01:28 | -0.100
2026-10-12 16:01:28 | 0.000
2026-10-12 16:01:28 | -0.100
2026-10-12 16:01:28 | 0.000
2026-10-12 16:01:28 | -0.100
2026-10-12 16:01:28 | -0.100
2026-10-12 16:01:28 | -0.100
2026-10-12 16:01:28 | 0.000
2026-10-12 16:01:28 | -0.100
2026-10-12 16:01:28 | 0.100
2026-10-12 16:01:28 | -0.100
2026-10-12 16:01:28 | -0.100
2026-10-12 16:01:29 | -0.100
2026-10-12 16:01:29 | -0.100
2026-10-12 16:01:29 | 0.100
2026-10-12 16:01:29 | -0.100
2026-10-12 16:01:29 | -0.100
2026-10-12 16:01:29 | -0.100
2026-10-12 16:01:29 | 0.000
2026-10-12 16:01:29 | 0.000
2026-10-12 16:01:29 | -0.200
2026-10-12 16:01:29 | 0.000
2026-10-12 16:01:29 | -0.100
2026-10-12 16:01:29 | 0.000
2026-10-12 16:01:29 | -0.200
2026-10-12 16:01:29 | 0.000
2026-10-12 16:01:29 | 0.100
2026-10-12 16:01:29 | -0.100
2026-10-12 16:01:29 | -0.100
2026-10-12 16:01:29 | -0.100
2026-10-12 16:01:29 | 0.100
2026-10-12 16:01:30 | -0.200
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
2026-10-12 16:04:49 | 1399.400
2026-10-12 16:04:49 | 1310.000
2026-10-12 16:04:50 | 1399.100
2026-10-12 16:04:50 | 1381.900
2026-10-12 16:04:50 | 1383.000
2026-10-12 16:04:50 | 1391.000
2026-10-12 16:04:50 | 1391.900
2026-10-12 16:04:50 | 1396.500
2026-10-12 16:04:50 | 1400.500
2026-10-12 16:04:50 | 1399.000
2026-10-12 16:04:50 | 1404.200
2026-10-12 16:04:50 | 1401.200
2026-10-12 16:04:50 | 1402.000
2026-10-12 16:04:50 | 1406.300
2026-10-12 16:04:50 | 1404.700
2026-10-12 16:04:50 | 1408.600
2026-10-12 16:04:50 | 1407.700
2026-10-12 16:04:50 | 1409.100
2026-10-12 16:04:50 | 1361.000
2026-10-12 16:04:50 | 1346.500
2026-10-12 16:04:50 | 1393.900
2026-10-12 16:04:51 | 1380.700
2026-10-12 16:04:51 | 1384.300
2026-10-12 16:04:51 | 1393.100
2026-10-12 16:04:51 | 1394.100
2026-10-12 16:04:51 | 1394.600
2026-10-12 16:04:51 | 1398.300
2026-10-12 16:04:51 | 1396.000
2026-10-12 16:04:51 | 1402.800
2026-10-12 16:04:51 | 1401.700
2026-10-12 16:04:51 | 1402.800
2026-10-12 16:04:51 | 1408.900
2026-10-12 16:04:51 | 1406.200
2026-10-12 16:04:51 | 1406.400
2026-10-12 16:04:51 | 1409.700
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
