olxssa/perfusion_automation/Data_for_Repository/Calibration_Benchmarking/Flow_Rate_Optimization/flow_rate_nrreservoirs_fillness_30s.csv

 | Time | Flow-rate [ul/min]
0 | 0.0 | -0.1
1 | 1.000127959053103 | 0.1
2 | 2.000255918106206 | -0.2
3 | 3.000383877159309 | 0.2
4 | 4.000511836212412 | -0.2
5 | 5.000639795265514 | -0.1
6 | 6.000767754318618 | 0.2
7 | 7.000895713371721 | -0.3
8 | 8.001023672424823 | 0.5
9 | 9.001151631477926 | -1.7
10 | 10.001279590531029 | 2.1
11 | 11.001407549584131 | -1.8
12 | 12.001535508637236 | -2.4
13 | 13.001663467690339 | 6.4
14 | 14.001791426743441 | 0.4
15 | 15.001919385796544 | -1.3
16 | 16.002047344849647 | 2.1
17 | 17.00217530390275 | -4.8
18 | 18.002303262955852 | 3.7
19 | 19.002431222008955 | -4.3
20 | 20.002559181062058 | 0.9
21 | 21.00268714011516 | 1.0
22 | 22.002815099168263 | -2.0
23 | 23.002943058221366 | 2.6
24 | 24.003071017274472 | -4.4
25 | 25.003198976327575 | 4.0
26 | 26.003326935380677 | -2.3
27 | 27.00345489443378 | 1.8
28 | 28.003582853486883 | -0.9
29 | 29.003710812539985 | -0.7
30 | 30.003838771593088 | 0.5
31 | 31.00396673064619 | -0.5
32 | 32.00409468969929 | 0.9
33 | 33.004222648752396 | -2.1
34 | 34.0043506078055 | 1.8
35 | 35.0044785668586 | 0.1
36 | 36.004606525911704 | -0.2
37 | 37.00473448496481 | -1.0
38 | 38.00486244401791 | -0.9
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
