olxssa/perfusion_automation/Data_for_Repository/Calibration_Benchmarking/Flow_Rate_Optimization/flow_rate_nrreservoirs_vary_30s.csv

Time | Flow-rate [ul/min]
2026-10-12 16:11:34 | -0.400
2026-10-12 16:11:34 | -0.500
2026-10-12 16:11:34 | -0.100
2026-10-12 16:11:34 | -0.200
2026-10-12 16:11:34 | -0.100
2026-10-12 16:11:35 | -0.200
2026-10-12 16:11:35 | -0.200
2026-10-12 16:11:35 | -0.100
2026-10-12 16:11:35 | -0.200
2026-10-12 16:11:35 | -0.100
2026-10-12 16:11:35 | -0.200
2026-10-12 16:11:35 | -0.100
2026-10-12 16:11:35 | 0.000
2026-10-12 16:11:35 | -0.200
2026-10-12 16:11:35 | -0.100
2026-10-12 16:11:35 | -0.100
2026-10-12 16:11:35 | 0.000
2026-10-12 16:11:35 | -0.100
2026-10-12 16:11:35 | -0.200
2026-10-12 16:11:35 | -0.100
2026-10-12 16:11:35 | -0.200
2026-10-12 16:11:35 | -0.100
2026-10-12 16:11:35 | -0.200
2026-10-12 16:11:35 | -0.100
2026-10-12 16:11:35 | -0.100
2026-10-12 16:11:35 | -0.100
2026-10-12 16:11:35 | -0.200
2026-10-12 16:11:36 | -0.100
2026-10-12 16:11:36 | -0.100
2026-10-12 16:11:36 | -0.200
2026-10-12 16:11:36 | -0.100
2026-10-12 16:11:36 | -0.200
2026-10-12 16:11:36 | 0.000
2026-10-12 16:11:36 | -0.200
2026-10-12 16:11:36 | -0.100
2026-10-12 16:11:36 | -0.200
2026-10-12 16:11:36 | -0.100
2026-10-12 16:11:36 | -0.100
2026-10-12 16:11:36 | -0.200
2026-10-12 16:11:36 | 0.000
2026-10-12 16:11:36 | -0.200
2026-10-12 16:11:36 | -0.100
2026-10-12 16:11:36 | -0.100
2026-10-12 16:11:36 | -0.100
2026-10-12 16:11:36 | 0.000
2026-10-12 16:11:36 | -0.300
2026-10-12 16:11:37 | -0.100
2026-10-12 16:11:37 | -0.100
2026-10-12 16:11:37 | -0.200
2026-10-12 16:11:37 | -0.100
2026-10-12 16:11:37 | -0.200
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
2026-10-12 16:15:02 | -0.100
2026-10-12 16:15:02 | 0.000
2026-10-12 16:15:02 | -0.100
2026-10-12 16:15:02 | -0.100
2026-10-12 16:15:02 | -0.100
2026-10-12 16:15:02 | -0.100
2026-10-12 16:15:02 | -0.100
2026-10-12 16:15:02 | -0.100
2026-10-12 16:15:02 | -0.100
2026-10-12 16:15:02 | -0.100
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
