olxssa/perfusion_automation/images/perfusion_experiment.jpg

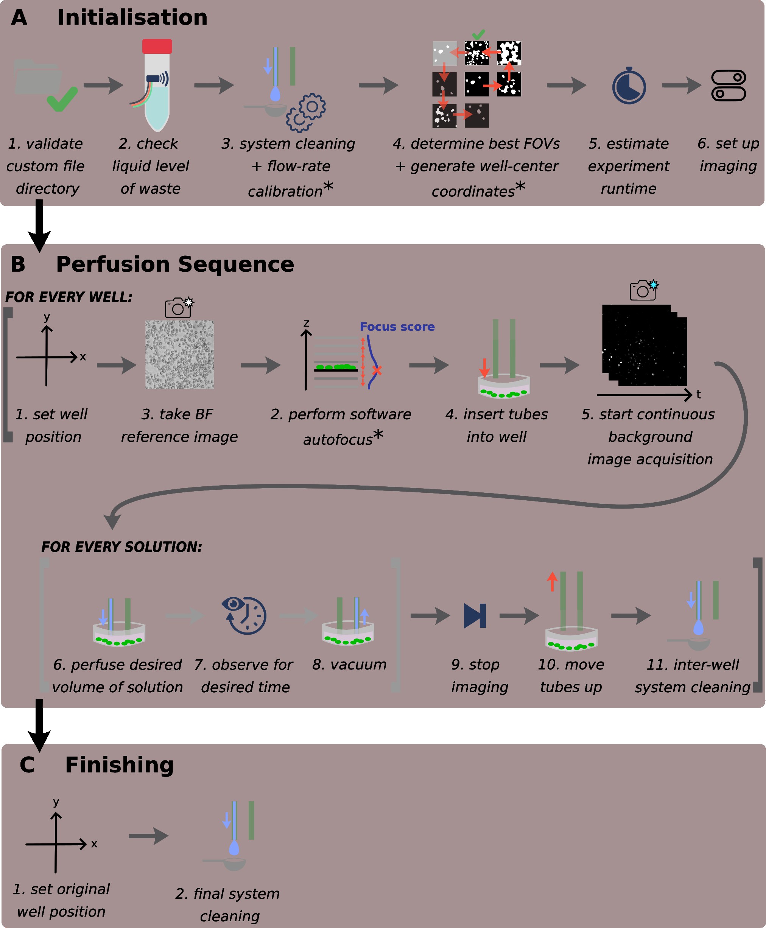
images/perfusion_experiment.jpg
