olxssa/perfusion_automation/images/perfusion_experiment.png

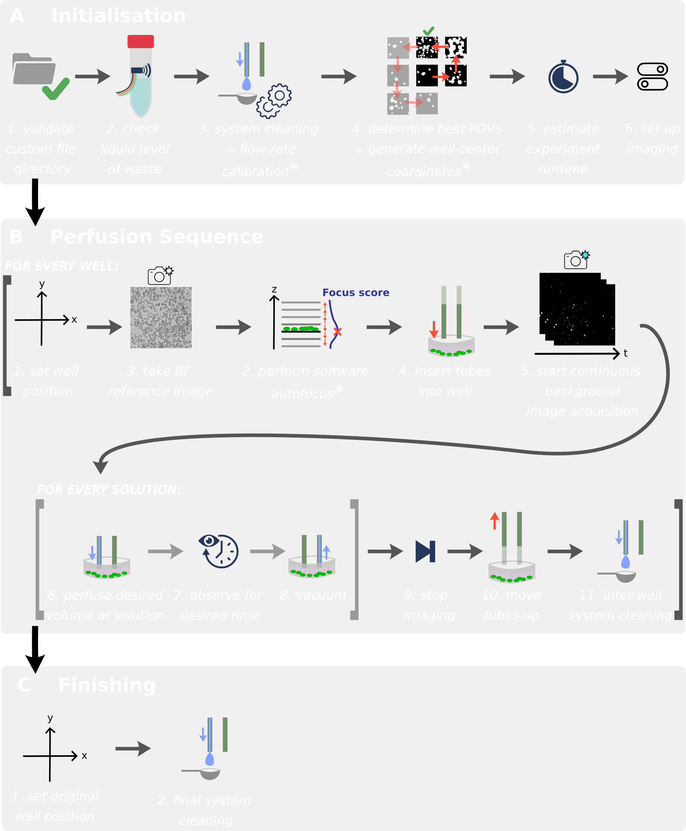
images/perfusion_experiment.png
