olxssa/perfusion_automation/FPC/custom_fpc_memetis_improved/custom_ffc.kicad_pcb

## KiCad design FPC/custom_fpc_memetis_improved/custom_ffc.kicad_pcb (2026-10-18)

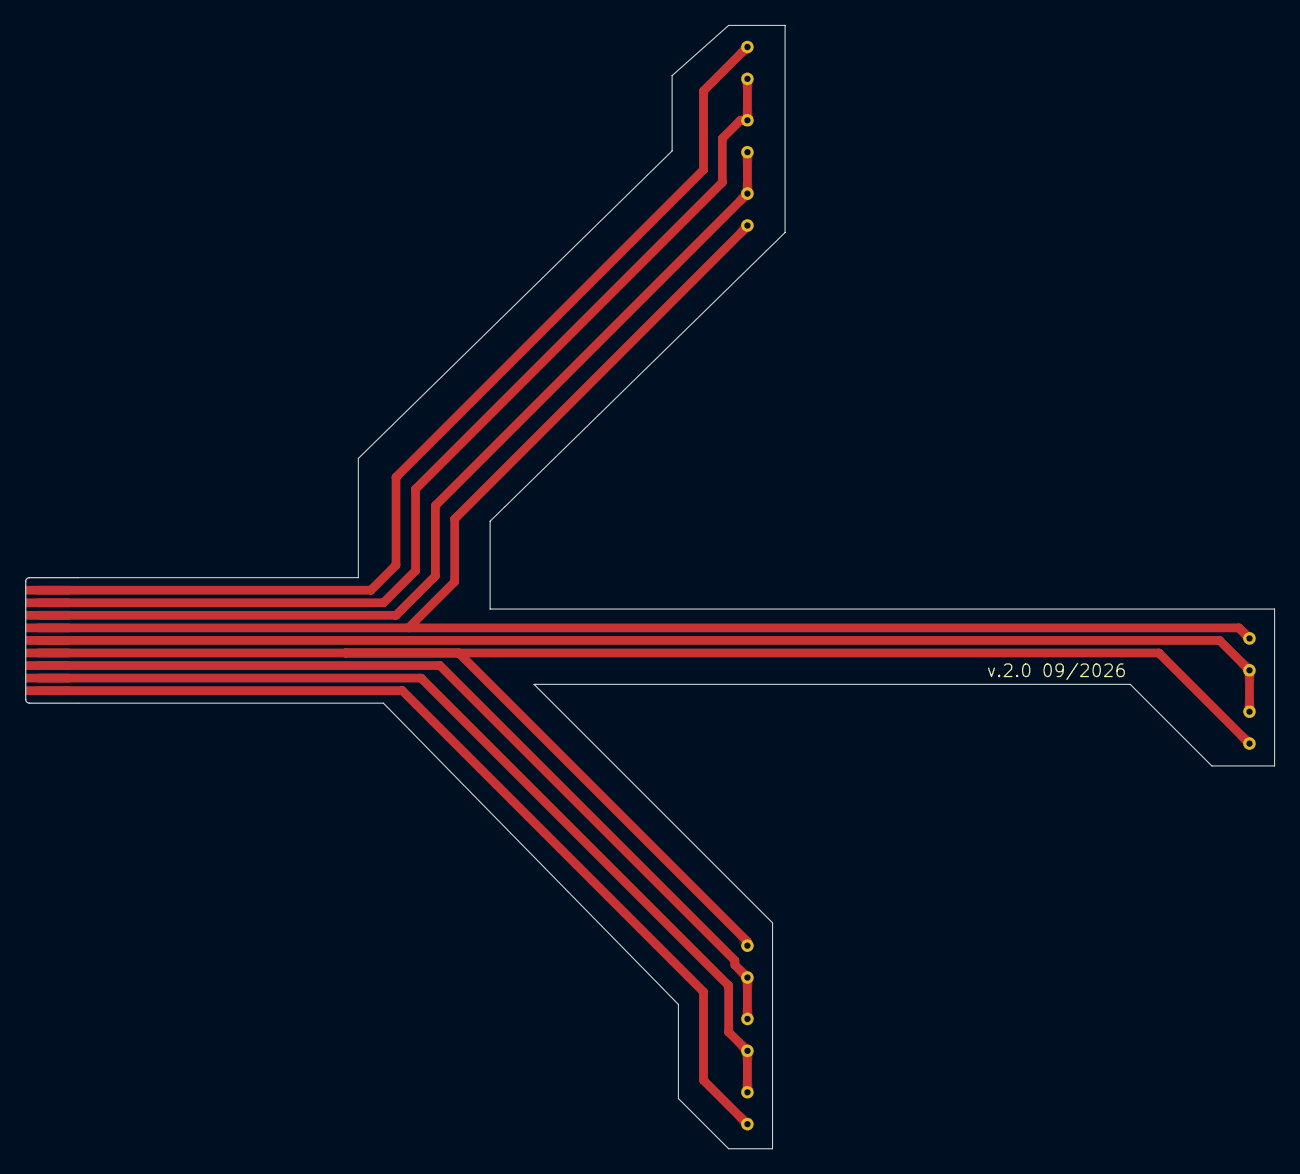
[picture p62: board custom_ffc.kicad_pcb from above]

Board: 2 copper layers, 99.5 x 89.5 mm, 8 parts (0 on the bottom side), 7 nets.

Parts:
J1, J2, J3, J4, J5, J6, J7, J8: Conn_01x02_Pin; memetis_01x02

Connections:
unnamed: J1.2, J2.1
unnamed: J2.2, J3.1
unnamed: J3.2, J4.1
unnamed: J4.2, J5.1
unnamed: J5.2, J6.1
unnamed: J6.2, J7.1
unnamed: J7.2, J8.1
