olxssa/perfusion_automation/app.py

from flask import Flask, render_template, request

app = Flask(__name__)

@app.route("/", methods=["GET", "POST"])
def index():
    if request.method == "POST":
        action = request.form.get("action")
        print(f"Button pressed: {action}")
    return render_template("index.html")

if __name__ == "__main__":
    app.run(debug=True)
